ProjectLadon/PowerHardware/README.md

# PowerHardware
Solar panel MPPT/battery charger/power combiner hardware
