ProjectLadon/PowerHardware/Combiner/BatteryChargerCombinerBoM.xlsx

Qty | Q3 | Value | Device | Package | Parts | Description | Part Number | Manufacturer | Notes
3 | 9 |  | DIODESOD-123 | SOD-123 | D7, D8, D9 | Diode | MBR0580S1-7 (https://www.digikey.com/product-detail/en/diodes-incorporated/MBR0580S1-7/MBR0580S1-7DICT-ND/5080371) | Diodes Inc | Digikey
2 | 6 |  | DIODESOT23_REFLOW | SOT23-R | D3, D4 | Diode | BAT750-TP (https://www.digikey.com/product-detail/en/micro-commercial-co/BAT750-TP/BAT750-TPMSCT-ND/7681652) | Micro Commercial | Digikey
4 | 12 |  | R-EU_R0603 | R0603 | R5, R6, R16, R17 | RESISTOR, European symbol |  |  | Digikey
2 | 6 | 100K | R-EU_R0603 | R0603 | R11, R24 | RESISTOR, European symbol | From stock |  | Digikey
14 | 42 | 100R | R-EU_R0603 | R0603 | R12, R19, R30, R33, R34, R40, R43, R44, R53, R54, R65, R68, R69, R71 | RESISTOR, European symbol | RC0603FR-07100RL (https://www.digikey.com/product-detail/en/yageo/RC0603FR-07100RL/311-100HRCT-ND/729835) | Yageo | Digikey
17 | 51 | 100n | C-EUC0603 | C0603 | C3, C4, C16, C17, C21, C24, C26, C28, C29, C30, C31, C32, C33, C34, C35, C38, C39 | CAPACITOR, European symbol | From stock |  | Digikey
15 | 45 | 10K | R-EU_R0603 | R0603 | R7, R8, R20, R21, R56, R57, R60, R73, R75, R77, R78, R85, R86, R87, R88 | RESISTOR, European symbol | From stock |  | Digikey
11 | 33 | 10M | R-EU_R0603 | R0603 | R27, R28, R35, R37, R51, R52, R55, R66, R67, R70, R72 | RESISTOR, European symbol | RC0603FR-0710ML (https://www.digikey.com/product-detail/en/yageo/RC0603FR-0710ML/311-10.0MHRCT-ND/729828) | Yageo | Digikey
2 | 6 | 10R | R-EU_R0603 | R0603 | R29, R36 | RESISTOR, European symbol | RC0603FR-0710RL (https://www.digikey.com/product-detail/en/yageo/RC0603FR-0710RL/311-10.0HRCT-ND/729826) | Yageo | Digikey
2 | 6 | 10R | R-EU_R1206 | R1206 | R2, R18 | RESISTOR, European symbol | RC1206FR-0710RL (https://www.digikey.com/product-detail/en/yageo/RC1206FR-0710RL/311-10.0FRCT-ND/731429) | Yageo | Digikey
6 | 18 | 10u | C-EUC1210 | C1210 | C2, C7, C8, C12, C13, C18 | CAPACITOR, European symbol | CC1210ZKY5VGBB106 (https://www.digikey.com/product-detail/en/yageo/CC1210ZKY5VGBB106/311-3546-1-ND/7164567) |  | Digikey
2 | 6 | 10u | INDUCTOR-DG6050 | DG6050 | L1, L2 |  | 1264EY-100M=P3 (https://www.digikey.com/product-detail/en/murata-electronics-north-america/1264EY-100M=P3/490-10814-1-ND/5271556) | Murata | Digikey
2 | 6 | 12K | R-EU_R0603 | R0603 | R62, R64 | RESISTOR, European symbol | From stock |  | Digikey
5 | 15 | 15K | R-EU_R0603 | R0603 | R4, R15, R59, R74, R76 | RESISTOR, European symbol | RC0603FR-0715KL (https://www.digikey.com/product-detail/en/yageo/RC0603FR-0715KL/311-15.0KHRCT-ND/729900) | Yageo | Digikey
6 | 18 | 1K | R-EU_R0603 | R0603 | R79, R80, R81, R82, R83, R84 | RESISTOR, European symbol | From stock |  | Digikey
6 | 18 | 1u | C-EUC0603 | C0603 | C5, C6, C14, C15, C22, C27 | CAPACITOR, European symbol | From stock |  | Digikey
2 | 6 | 220mA/50V/3.5O | MOSFET-NCH-BSS138 | SOT23-3 | Q6, Q7 | N-channel MOSFETs | NTR5103NT1G (https://www.digikey.com/product-detail/en/on-semiconductor/NTR5103NT1G/NTR5103NT1GOSCT-ND/5801875) | ON Semi | Digikey
2 | 6 | 22p | C-EUC0603 | C0603 | C10, C20 | CAPACITOR, European symbol | 06035A220JAT2A (https://www.digikey.com/product-detail/en/avx-corporation/06035A220JAT2A/478-1167-1-ND/564199) | AVX | Digikey
2 | 6 | 232K | R-EU_R0603 | R0603 | R3, R14 | RESISTOR, European symbol | RC0603FR-07232KL (https://www.digikey.com/product-detail/en/yageo/RC0603FR-07232KL/311-232KHRCT-ND/730019) | Yageo | Digikey
2 | 6 | 2R | R-EU_R0603 | R0603 | R1, R13 | RESISTOR, European symbol | RMCF0603FT2R00 (https://www.digikey.com/product-detail/en/stackpole-electronics-inc/RMCF0603FT2R00/RMCF0603FT2R00CT-ND/6053160) | Stackpole | Digikey
2 | 6 | 2S-BATTERYSMD | 2S-BATTERYSMD | JST-XH3-SMD | BAT1, BAT2 | JST XH connector for a 2S LiPo battery with balancing | S3B-XH-SM4-TB(LF)(SN) (https://www.digikey.com/product-detail/en/jst-sales-america-inc/S3B-XH-SM4-TB-LF-SN/455-2263-1-ND/1651061) | JST | Digikey
2 | 6 | 2m | R-EU_R2512 | R2512 | R32, R42 | RESISTOR, European symbol | PA2512FKF070R002E (https://www.digikey.com/product-detail/en/yageo/PA2512FKF070R002E/YAG2137CT-ND/5139585) | Yageo | Digikey
5 | 15 | 2u2 | C-EUC0603 | C0603 | C1, C11, C23, C25, C37 | CAPACITOR, European symbol | CL10A225KL8NNNC (https://www.digikey.com/product-detail/en/samsung-electro-mechanics/CL10A225KL8NNNC/1276-6726-1-ND/5961585) | Samsung | Digikey
2 | 6 | 300K | R-EU_R0603 | R0603 | R10, R23 | RESISTOR, European symbol | RC0603FR-07300KL (https://www.digikey.com/product-detail/en/yageo/RC0603FR-07300KL/311-300KHRCT-ND/730092) | Yageo | Digikey
4 | 12 | 4.3A/20V/54mO | MOSFET_PCH-IRLML2244 | SOT23-3 | Q8, Q9, Q10, Q11 | P-channel MOSFETs | DMP3099L-7 (https://www.digikey.com/product-detail/en/diodes-incorporated/DMP3099L-7/DMP3099L-7DICT-ND/5218217) | Diodes Inc | Digikey
2 | 6 | 40m | R-EU_R2512 | R2512 | R9, R22 | RESISTOR, European symbol | PE2512FKE070R04L (https://www.digikey.com/product-detail/en/yageo/PE2512FKE070R04L/YAG2155CT-ND/5139603) | Yageo | Digikey
1 | 3 | 470p | C-EUC0603 | C0603 | C36 | CAPACITOR, European symbol | CL10B471KB8NNNC (https://www.digikey.com/product-detail/en/samsung-electro-mechanics/CL10B471KB8NNNC/1276-1094-1-ND/3889180) | Samsung | Digikey
7 | 21 | 4K7 | R-EU_R0603 | R0603 | R45, R46, R47, R48, R49, R50, R58 | RESISTOR, European symbol | From stock |  | Digikey
2 | 6 | 4u7 | C-EUC1210 | C1210 | C9, C19 | CAPACITOR, European symbol | CC1210KKX5R9BB475 (https://www.digikey.com/product-detail/en/yageo/CC1210KKX5R9BB475/311-3533-1-ND/7164554) |  | Digikey
4 | 12 | 5K1 | R-EU_R0603 | R0603 | R25, R26, R38, R39 | RESISTOR, European symbol | RC0603FR-075K1L (https://www.digikey.com/product-detail/en/yageo/RC0603FR-075K1L/311-5.10KHRCT-ND/730215) | Yageo | Digikey
2 | 6 | 5R | R-EU_R0603 | R0603 | R31, R41 | RESISTOR, European symbol | RMCF0603FT4R99 (https://www.digikey.com/product-detail/en/stackpole-electronics-inc/RMCF0603FT4R99/RMCF0603FT4R99CT-ND/2418080) | Stackpole | Digikey
1 | 3 | 74AHC1G07DBV | 74AHC1G07DBV | SOT23-5 | U8 | Single Buffer/Driver With Open-Drain Output | MC74VHC1G07DTT1G (https://www.digikey.com/product-detail/en/on-semiconductor/MC74VHC1G07DTT1G/MC74VHC1G07DTT1GOSCT-ND/1967117) | ON Semi | Digikey
4 | 12 | 74AUC1G06DBV | 74AUC1G06DBV | SOT23-5 | U9, U14, U15, U16 | Single Inverter Buffer/Driver With Open-Drain Output | SN74LVC1G06DBVR (https://www.digikey.com/product-detail/en/texas-instruments/SN74LVC1G06DBVR/296-8483-1-ND/377451) | TI | Digikey
2 | 6 | 75K | R-EU_R0603 | R0603 | R61, R63 | RESISTOR, European symbol | RC0603FR-0775KL (https://www.digikey.com/product-detail/en/yageo/RC0603FR-0775KL/311-75.0KHRCT-ND/730325) | Yageo | Digikey
5 | 15 | BLU | LEDCHIP-LED0603 | CHIP-LED0603 | 5V_PWR, BAT1_PWR, BAT2_PWR, PANEL1_PWR, PANEL2_PWR | LED | 150060BS75000 (https://www.digikey.com/product-detail/en/wurth-electronics-inc/150060BS75000/732-4966-1-ND/4489893) | Wurth | Digikey
2 | 6 | BQ24650 | BQ24650 | QFN16 | U1, U4 | TI LiPo charger with MPPT | BQ24650RVAT (https://www.digikey.com/product-detail/en/texas-instruments/BQ24650RVAT/296-27699-1-ND/2352706) | TI | Digikey
2 | 6 | BQ28Z610 | BQ28Z610 | PDSO-N12 | U2, U3 | 2S LiPo balancer/fuel gauge | BQ28Z610DRZT (https://www.digikey.com/product-detail/en/texas-instruments/BQ28Z610DRZT/296-43394-1-ND/5813465) | TI | Digikey
4 | 12 | DMN6040SSD-13 | IRF8313P | SO-08 | Q1, Q2, Q3, Q4 | HEXFET(R) Power MOSFET | DMN6040SSD-13 (https://www.digikey.com/product-detail/en/diodes-incorporated/DMN6040SSD-13/DMN6040SSD-13DICT-ND/3481122) | Diodes Inc | Digikey
1 | 3 | DMP4047SSD-13 | DMP4047SSD-13 | SO08 | Q5 | Dual P MOSFET | DMP4047SSD-13 (https://www.digikey.com/product-detail/en/diodes-incorporated/DMP4047SSD-13/DMP4047SSD-13DICT-ND/5147416) | Diodes Inc | Digikey
1 | 3 | GRN | LEDCHIP-LED0603 | CHIP-LED0603 | 3V3_PWR | LED | 150060GS75000 (https://www.digikey.com/product-detail/en/wurth-electronics-inc/150060GS75000/732-4971-1-ND/4489896) | Wurth | Digikey
1 | 3 | HEADER_POS15_70545 | HEADER_POS15_70545 | 70545-POS15 | SYSTEM | Molex -C-Gridï¿½ / SL Series connector | 705450049 (https://www.digikey.com/product-detail/en/molex-connector-corporation/0705450049/WM14780-ND/3302397) | Molex | Digikey
3 | 9 | HEADER_POS3_70545 | HEADER_POS3_70545 | 70545-POS3 | BAT1_TS, BAT2_TS, TAIL | Molex -C-Gridï¿½ / SL Series connector | 705450072 (https://www.digikey.com/product-detail/en/molex-llc/0705450072/WM14782-ND/3302409) | Molex | Digikey
3 | 9 | HEADER_POS4_70545 | HEADER_POS4_70545 | 70545-POS4 | ANEMOMETER, MASTHEAD, ROTATION | Molex -C-Gridï¿½ / SL Series connector | 705450003 (https://www.digikey.com/product-detail/en/molex-connector-corporation/0705450003/WM4186-ND/455677) | Molex | Digikey
1 | 3 | LMV358 | LMV358SOIC | SO08 | U17 | IC LMV358 DUAL OP AMP | LMV358SG-13 (https://www.digikey.com/product-detail/en/diodes-incorporated/LMV358SG-13/LMV358SG-13DICT-ND/2182572) | Diodes Inc | Digikey
1 | 3 | MIC5219 3.3V | V_REG_MIC52193.3V | SOT23-5 | U11 | V_REG MIC5219 | MIC5219-3.3YM5-TR (https://www.digikey.com/product-detail/en/microchip-technology/MIC5219-3.3YM5-TR/576-1281-1-ND/771902) | Microchip | Digikey
1 | 3 | female Mill-Max 0.1" header strip | MKR1000-SMD | MKR1000-SMD | U12 | 0.1" SMD header -- cut to length. Mates with Mill-Max series 350 or 800 | ED4164-63-ND (https://www.digikey.com/product-detail/en/mill-max-manufacturing-corp/310-43-163-41-105000/ED4164-63-ND/4455145) | Mill-Max | Digikey
1 | 3 | PWR | PWR | JST-XH2-THRUHOLE | PWR_OUT |  | S2B-XH-A(LF)(SN) (https://www.digikey.com/product-detail/en/jst-sales-america-inc/S2B-XH-A-LF-SN/455-2257-ND/1651055) | JST | Digikey
4 | 12 | RED | LEDCHIP-LED0603 | CHIP-LED0603 | BAT1_STAT1, BAT1_STAT2, BAT2_STAT1, BAT2_STAT2 | LED | 150060RS75000 (https://www.digikey.com/product-detail/en/wurth-electronics-inc/150060RS75000/732-4978-1-ND/4489899) | Wurth | Digikey
2 | 6 | SCHOTTKY-SOD128 | SCHOTTKY-SOD128 | SOD-128 | D1, D2 |  | PMEG4020ETP,115 (https://www.digikey.com/product-detail/en/nexperia-usa-inc/PMEG4020ETP115/1727-1730-1-ND/4581267) | Nexperia | Digikey
1 | 3 | STWD100 | STWD100 | DBV-R-PDSO-G5 | U13 |  | STWD100NYWY3F (https://www.digikey.com/product-detail/en/stmicroelectronics/STWD100NYWY3F/497-10058-1-ND/2175107) | STM | Digikey
1 | 3 | TCA9543A | TCA9543A | SO-14 | U5 | 2 port I2C mux | TCA9543ADR (https://www.digikey.com/product-detail/en/texas-instruments/TCA9543ADR/296-42064-1-ND/5246241) | TI | Digikey
1 | 3 | TS7211 | TS7211 | DBV-R-PDSO-G5 | U10 | Single rail to rail differential comparator. | TS7211AILT (https://www.digikey.com/product-detail/en/stmicroelectronics/TS7211AILT/497-3046-1-ND/634884) | STM | Digikey
1 | 3 | WE-78 | 5V | WE-78 | U6 |  | 173950578 (https://www.digikey.com/product-detail/en/wurth-electronics-inc/173950578/732-8243-5-ND/5725367) | Wurth | Digikey
1 | 3 | WE-78 | 3.3V | WE-78 | U7 |  | 173950378 (https://www.digikey.com/product-detail/en/wurth-electronics-inc/173950378/732-8242-5-ND/5725366) | Wurth | Digikey
