ProjectLadon/PowerHardware/MastheadLight/MastheadLightBoM.xlsx

Qty | Value | Device | Package | Parts | Description | Part Number | Manufacturer | Supplier
1 |  | DIODESOD-123 | SOD-123 | D1 | Diode | MBR0580S1-7 (https://www.digikey.com/product-detail/en/diodes-incorporated/MBR0580S1-7/MBR0580S1-7DICT-ND/5080371) | Diodes Inc | Digikey
6 |  | PINHD-2X3 | 2X03 | JP1, JP2, JP3, JP4, JP5, JP6 | PIN HEADER | PPTC032LFBN-RC (https://www.digikey.com/product-detail/en/sullins-connector-solutions/PPTC032LFBN-RC/S7071-ND/810210) |  | Digikey
1 | 1R1 | R-EU_R1206 | R1206 | R1 | RESISTOR, European symbol | ERJ-8BQF1R1V (https://www.digikey.com/product-detail/en/panasonic-electronic-components/ERJ-8BQF1R1V/P17601TR-ND/5647634) | Panasonic | Digikey
1 | 1u | C-EUC0603 | C0603 | C2 | CAPACITOR, European symbol | From stock |  | Digikey
1 | 33 uH/390 mA | INDUCTOR-LQH32N | C1210 | L1 |  | CBC3225T330MR (https://www.digikey.com/product-detail/en/taiyo-yuden/CBC3225T330MR/587-5508-1-ND/7067184) | Taiyo Yuden | Digikey
3 | 47K | R-EU_R0603 | R0603 | R2, R3, R4 | RESISTOR, European symbol | From stock |  | Digikey
1 | 4u7 | C-EUC1206 | C1206 | C1 | CAPACITOR, European symbol | TMK316BJ475KL-T (https://www.digikey.com/product-detail/en/taiyo-yuden/TMK316BJ475KL-T/587-1336-1-ND/931113) | Taiyo Yuden | Digikey
1 | HEADER_POS4_70543 | HEADER_POS4_70543 | 70543-POS4 | X1 | Molex -C-Gridï¿½ / SL Series connector | 705450003 (https://www.digikey.com/product-detail/en/molex-connector-corporation/0705450003/WM4186-ND/455677) | Molex | Digikey
1 | LM3407 | LM3407 | MSOP8-GND | U1 |  | LM3407MY/NOPB (https://www.digikey.com/product-detail/en/texas-instruments/LM3407MY-NOPB/LM3407MY-NOPBCT-ND/1993974) | TI | Digikey
1 | WE-78 | 5V | WE-78 | U6 |  | 173950578 (https://www.digikey.com/product-detail/en/wurth-electronics-inc/173950578/732-8243-5-ND/5725367) | Wurth | Digikey
6 |  | PINHD-2X3_2.54-SMD-90ï¿½ | 2X03SMD/90 | JP1 | PIN HEADER | TSM-103-01-L-DH (https://www.digikey.com/product-detail/en/samtec-inc/TSM-103-01-L-DH/SAM9026-ND/2501234) |  | Digikey
12 | 100n | C-EUC0603 | C0603 | C1, C2 | CAPACITOR, European symbol | From stock |  | Digikey
6 | LED | LED | LM561C | D1 |  | SPMWHT541ML5XAR0S6 (https://www.digikey.com/product-detail/en/samsung-semiconductor-inc/SPMWHT541ML5XAR0S6/1510-2182-1-ND/6569493) | Samsung | Digikey
12 | WS2812B5050 | WS2812B5050 | WS2812B | LED1, LED2 |  | NeoPixel 5050 RGB LED (https://www.adafruit.com/product/1655) |  | Adafruit
