ProjectLadon/PowerHardware/MPPTBatteryCharger/MPPTBatteryCharger.brd

## EAGLE design MPPTBatteryCharger/MPPTBatteryCharger.brd (2019-10-13)

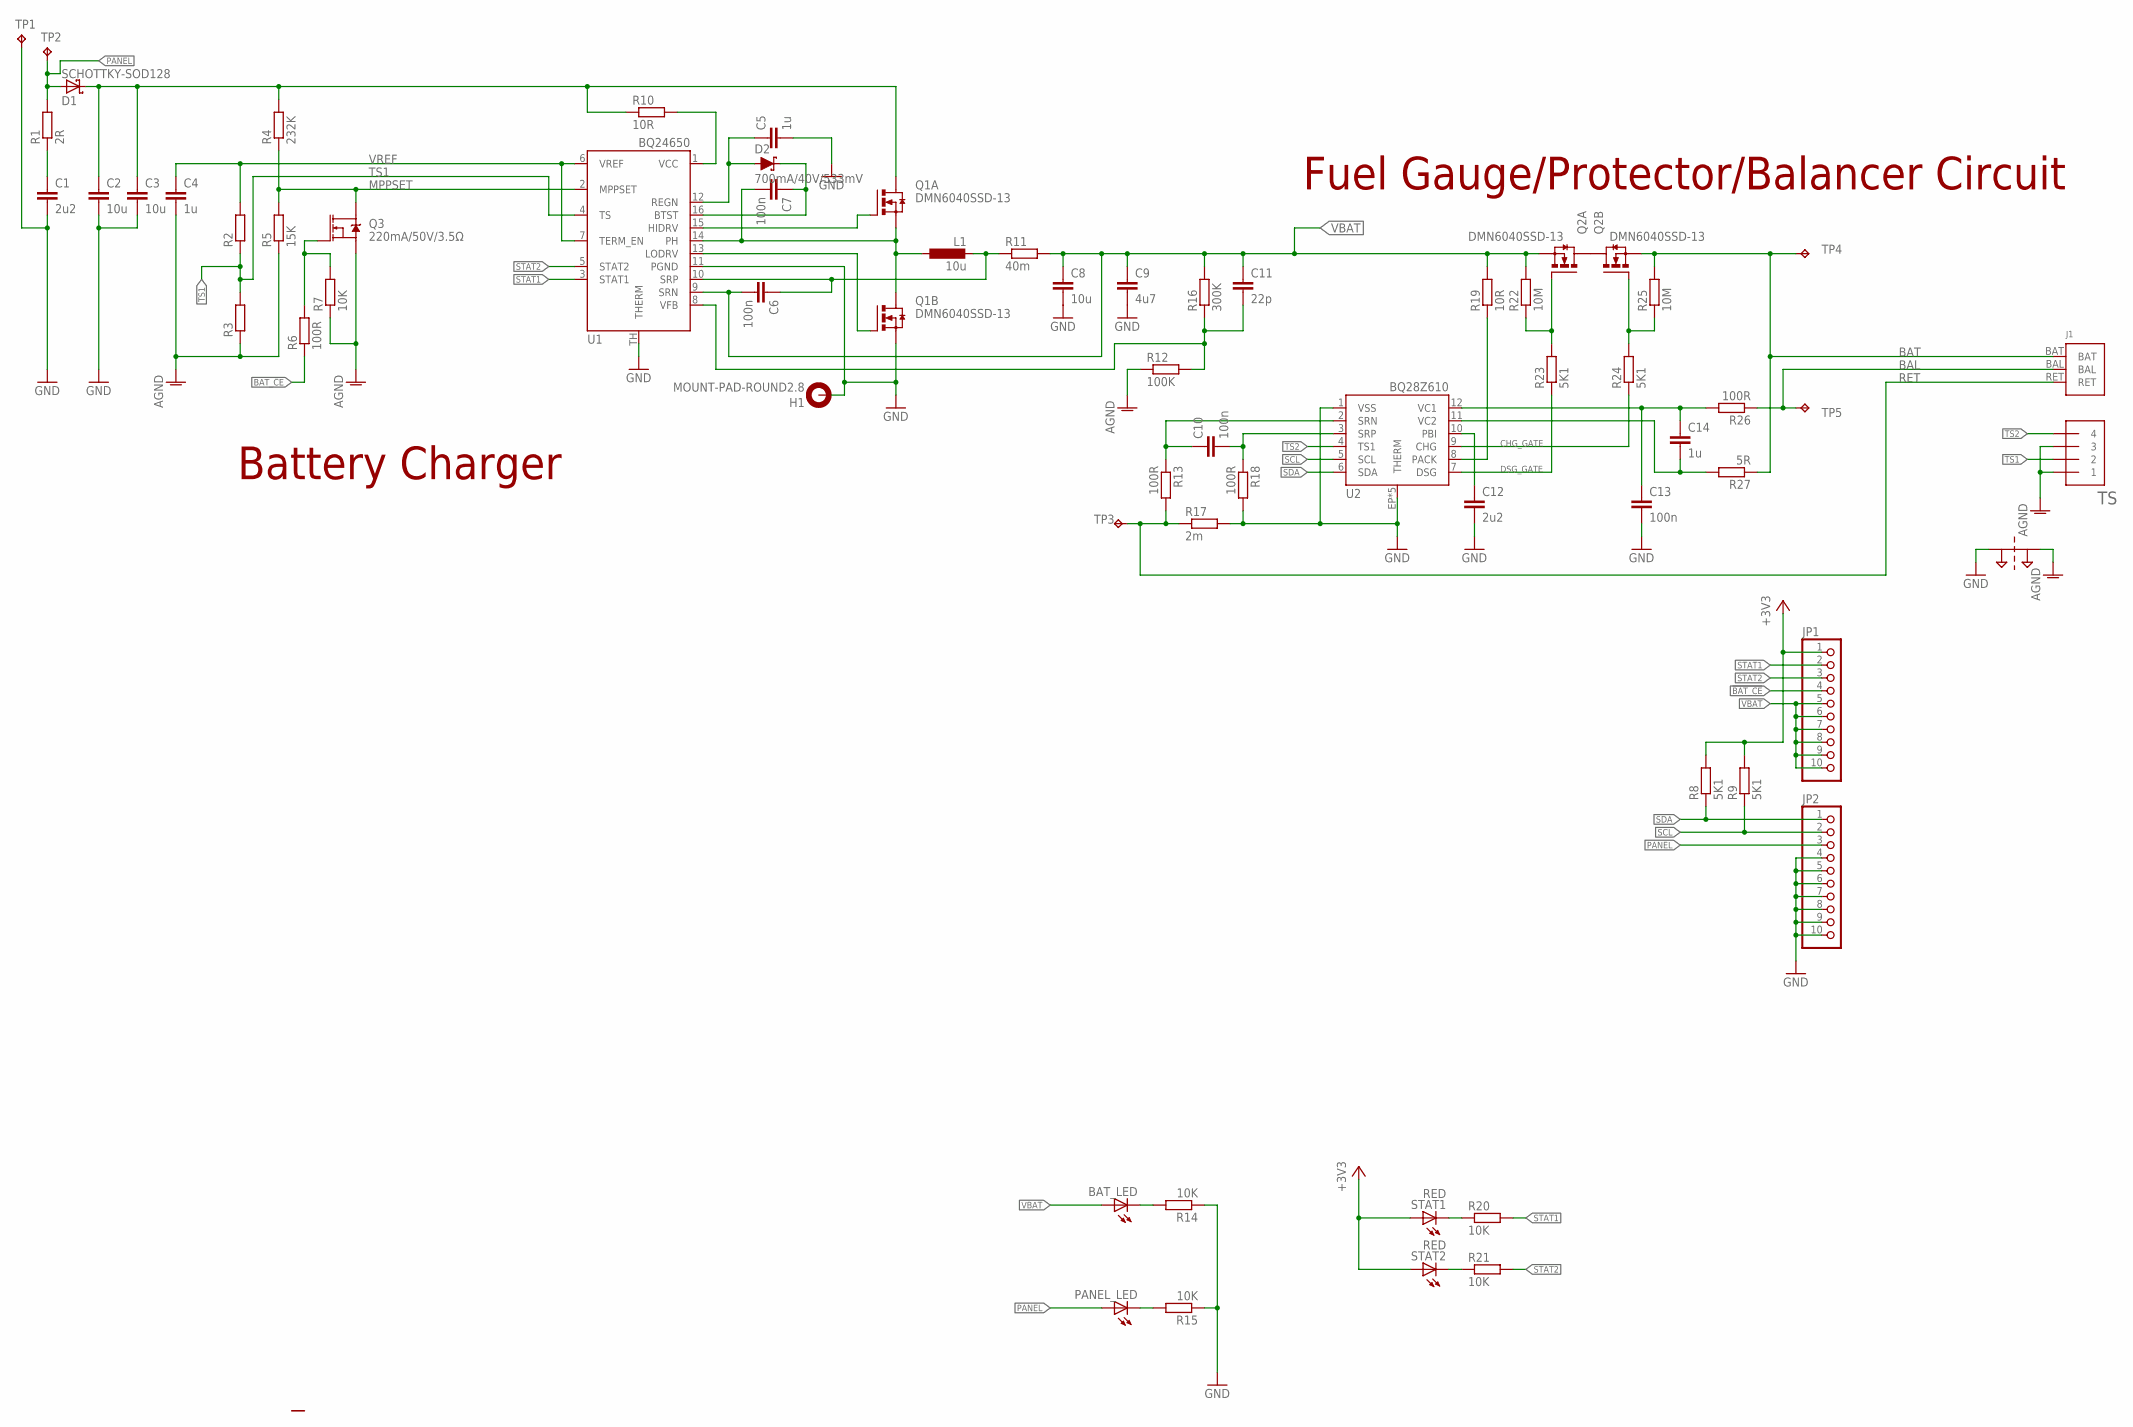
[picture p1: schematic MPPTBatteryCharger.sch]

Parts:
BAT_LED: LEDCHIP-LED0603; CHIP-LED0603
C1, C12: 2u2; C0603
C2, C3, C8: 10u; C1210
C4, C5, C14: 1u; C0603
C6, C7, C10, C13: 100n; C0603
C9: 4u7; C1210
C11: 22p; C0603
D1: SCHOTTKY-SOD128; SOD-128
D2: 700mA/40V/533mV; SOT23-3
H1: MOUNT-PAD-ROUND2.8; 2,8-PAD
J1: 2S-BATTERYSMD; JST-XH3-SMD
JP1, JP2: PINHD-1X10; 1X10
L1: 10u; DG6050
PANEL_LED: LEDCHIP-LED0603; CHIP-LED0603
Q1, Q2: DMN6040SSD-13; SO-08
Q3: 220mA/50V/3.5Ω; SOT23-3
R1: 2R; R0603
R2, R3: R-EU_R0603; R0603
R4: 232K; R0603
R5: 15K; R0603
R6, R13, R18, R26: 100R; R0603
R7, R14, R15, R20, R21: 10K; R0603
R8, R9, R23, R24: 5K1; R0603
R10: 10R; R1206
R11: 40m; R2512
R12: 100K; R0603
R16: 300K; R0603
R17: 2m; R2512
R19: 10R; R0603
R22, R25: 10M; R0603
R27: 5R; R0603
STAT1, STAT2: RED; CHIP-LED0603
SUPPLY1: 2PT_GND_TIE
TP1, TP2, TP3, TP4, TP5: TPPAD1-13Y; P1-13Y
TS: STRAWSON_EAGLE_LIB_JST_SH_4; STRAWSON_EAGLE_LIB_JST_SH_4_SMD
U1: BQ24650; QFN16
U2: BQ28Z610; PDSO-N12

Connections:
!BAT_CE!: JP1.4, R6.1
+3V3: JP1.1, R8.2, R9.2, STAT1.A, STAT2.A
AGND: C4.2, Q3.2 (S), R3.1, R5.1, R7.1, R12.1, SUPPLY1.P$2, TS.1, TS.3
BAL: J1.BAL, R26.1, TP5.TP
BAT: J1.BAT, Q2.1 (S), R25.2, R27.1, TP4.TP
CHG_GATE: R24.1, U2.9 (CHG)
DSG_GATE: R23.1, U2.7 (DSG)
GND: C1.2, C2.2, C3.2, C5.2, C8.2, C9.2, C12.2, C13.2, H1.B2,8, JP2.4, JP2.5, JP2.6, JP2.7, JP2.8, JP2.9, JP2.10, Q1.1 (S), R14.1, R15.1, R17.2, R18.2, SUPPLY1.P$1, TP1.TP, U1.11 (PGND), U1.TH (THERM), U2.1 (VSS), U2.EP (THERM), U2.EP1 (THERM), U2.EP2 (THERM), U2.EP3 (THERM), U2.EP4 (THERM)
MPPSET: Q3.3 (D), R4.1, R5.2, U1.2 (MPPSET)
unnamed: C1.1, R1.1
unnamed: R10.2, U1.1 (VCC)
unnamed: C2.1, C3.1, D1.C, Q1.5 (D), Q1.6 (D), R4.2, R10.1
unnamed: Q1.4 (G), U1.15 (HIDRV)
unnamed: C7.2, L1.1, Q1.3 (S), Q1.7 (D), Q1.8 (D), U1.14 (PH)
unnamed: Q1.2 (G), U1.13 (LODRV)
unnamed: Q3.1 (G), R6.2, R7.2
unnamed: C6.1, L1.2, R11.1, U1.10 (SRP)
unnamed: C7.1, D2.3 (C), U1.16 (BTST)
unnamed: C5.1, D2.1 (A), U1.12 (REGN)
unnamed: C11.2, R12.2, R16.1, U1.8 (VFB)
unnamed: R20.1, STAT1.C
unnamed: R19.1, U2.8 (PACK)
unnamed: Q2.5 (D), Q2.6 (D), Q2.7 (D), Q2.8 (D)
unnamed: Q2.4 (G), R22.1, R23.2
unnamed: Q2.2 (G), R24.2, R25.1
unnamed: C13.1, C14.1, R26.2, U2.12 (VC1)
unnamed: C14.2, R27.2, U2.11 (VC2)
unnamed: C12.1, U2.10 (PBI)
unnamed: C10.1, R13.1, U2.2 (SRN)
unnamed: C10.2, R18.1, U2.3 (SRP)
unnamed: R21.1, STAT2.C
unnamed: BAT_LED.C, R14.2
unnamed: PANEL_LED.C, R15.2
PANEL: D1.A, JP2.3, PANEL_LED.A, R1.2, TP2.TP
RET: J1.RET, R13.2, R17.1, TP3.TP
SCL: JP2.2, R9.1, U2.5 (SCL)
SDA: JP2.1, R8.1, U2.6 (SDA)
STAT1: JP1.2, R20.2, U1.3 (STAT1)
STAT2: JP1.3, R21.2, U1.5 (STAT2)
TS1: R2.1, R3.2, TS.2, U1.4 (TS)
TS2: TS.4, U2.4 (TS1)
VBAT: BAT_LED.A, C6.2, C8.1, C9.1, C11.1, JP1.5, JP1.6, JP1.7, JP1.8, JP1.9, JP1.10, Q2.3 (S), R11.2, R16.2, R19.2, R22.2, U1.9 (SRN)
VREF: C4.1, R2.2, U1.6 (VREF), U1.7 (TERM_EN)

Notes on the sheet:
Battery Charger
Fuel Gauge/Protector/Balancer Circuit

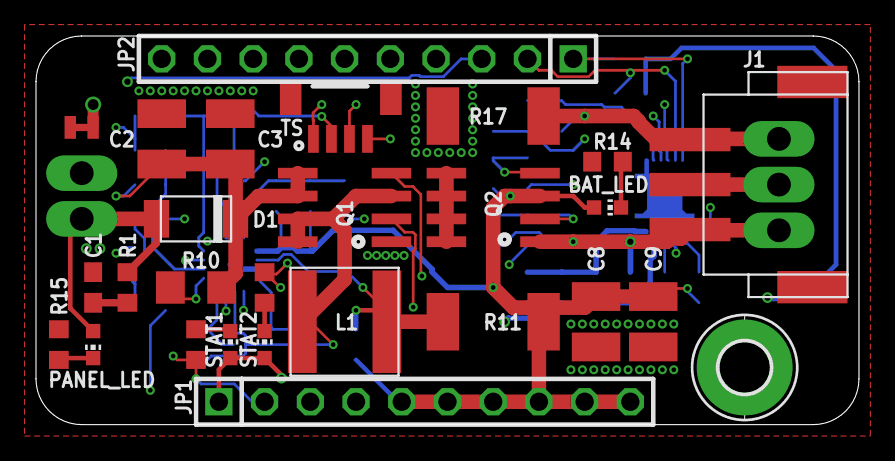
[picture p2: board MPPTBatteryCharger.brd from above]

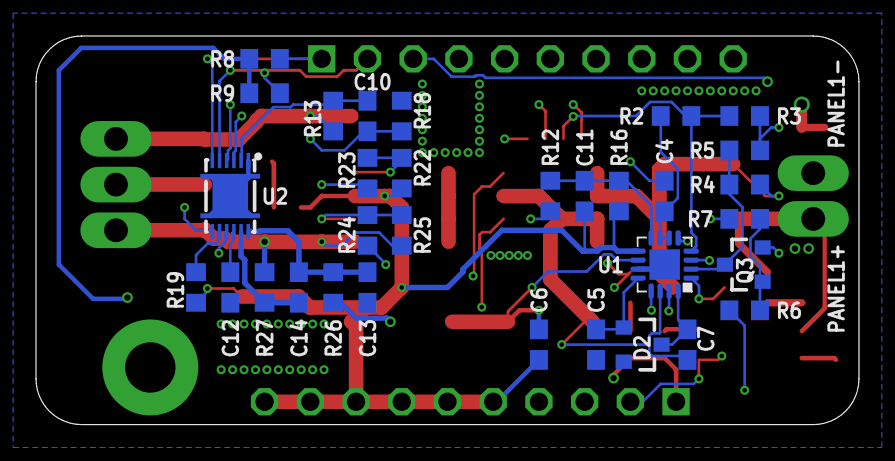
[picture p3: board MPPTBatteryCharger.brd from below]

Board: 4 copper layers, 45.7 x 21.6 mm, 64 parts (35 on the bottom side), 43 nets.
