ProjectLadon/PowerHardware/ModularCombinerBoard/BatteryCombinerControlBoard.brd

## EAGLE design ModularCombinerBoard/BatteryCombinerControlBoard.brd (2019-10-13)

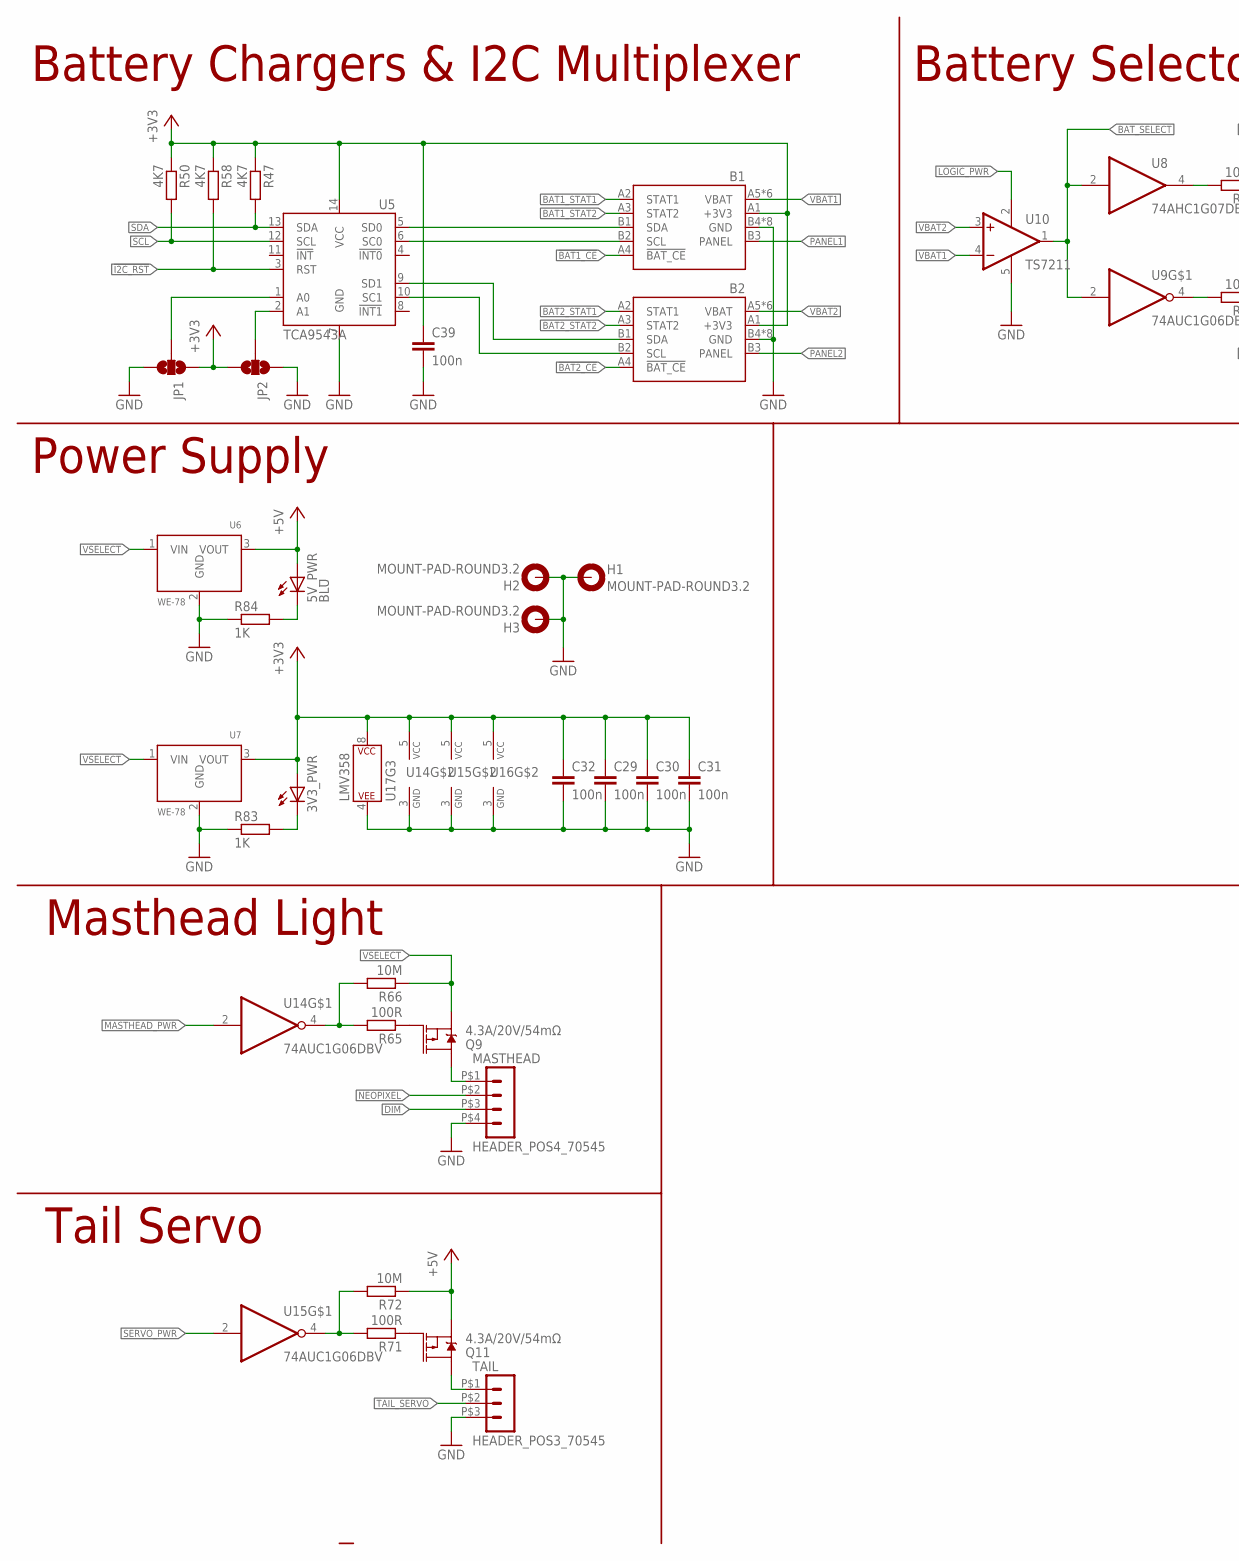
[picture p4: schematic BatteryCombinerControlBoard.sch, sheet 1, part in row 1, column 1]

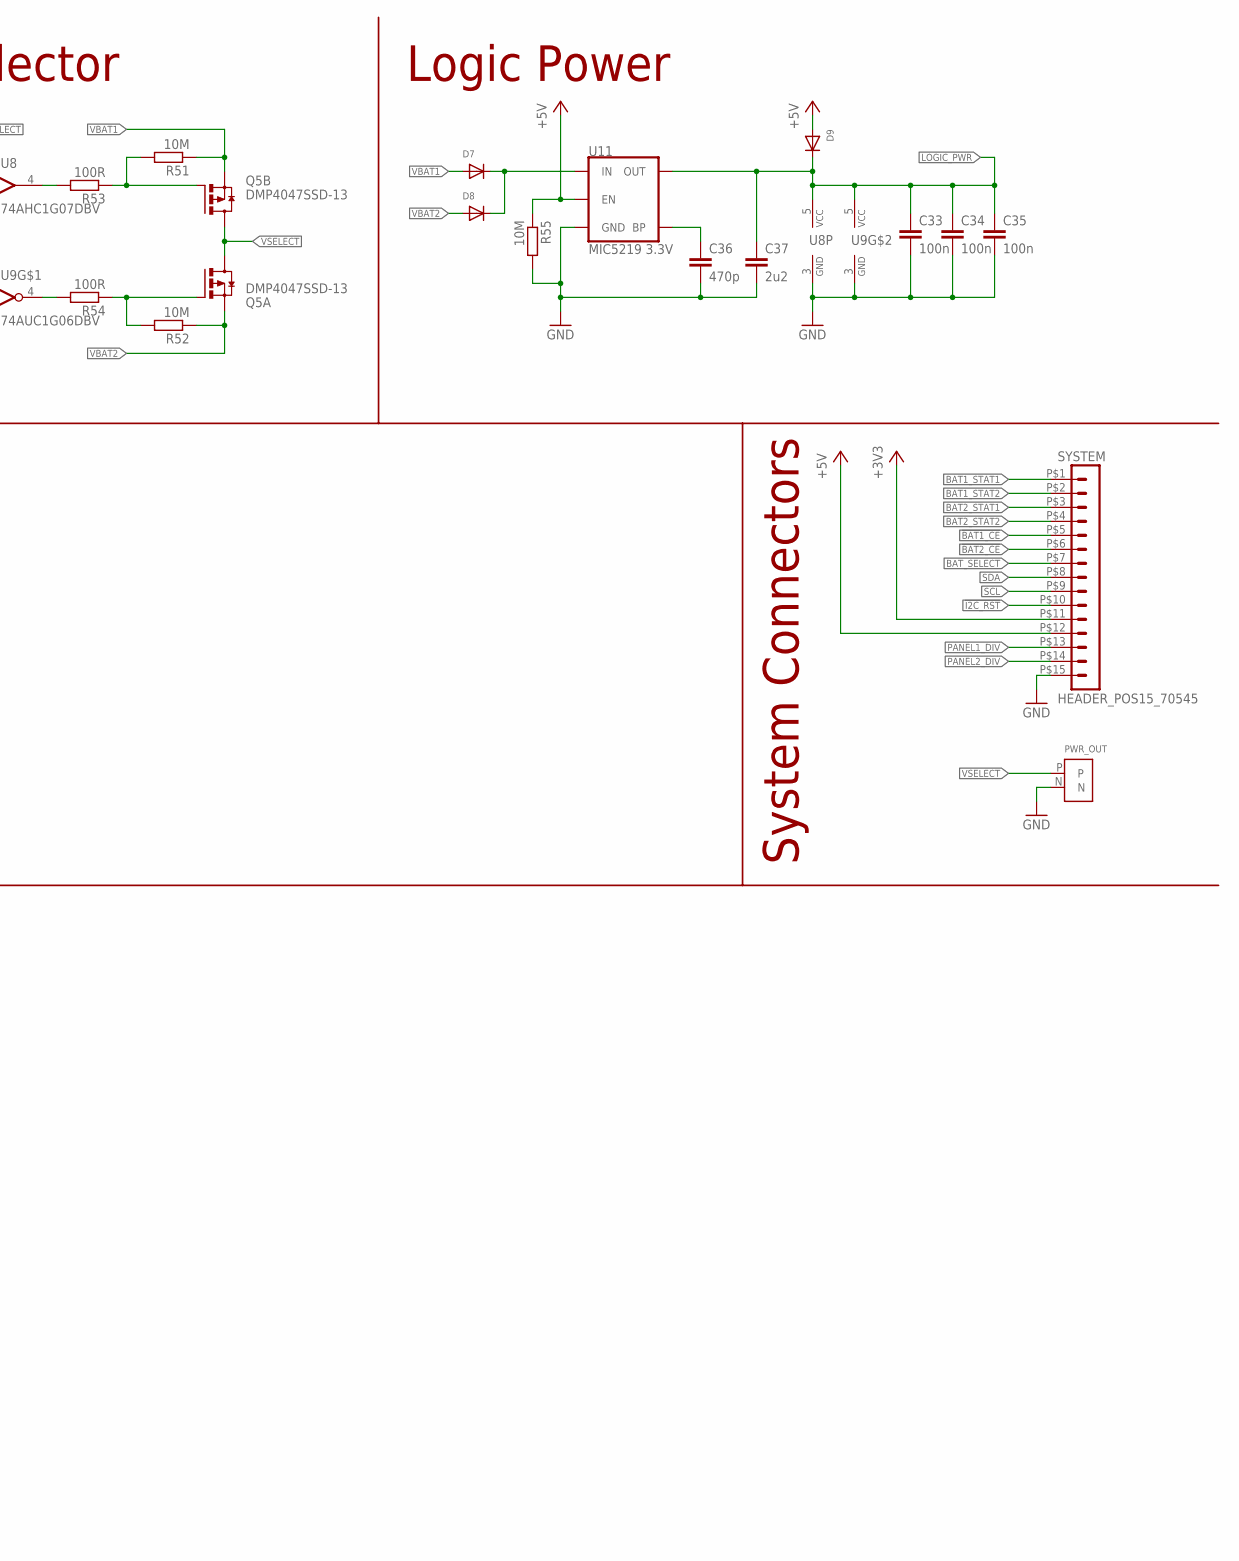
[picture p5: schematic BatteryCombinerControlBoard.sch, sheet 1, part in row 1, column 2]

Parts:
3V3_PWR: GRN; CHIP-LED0603
5V_PWR: BLU; CHIP-LED0603
B1, B2: MPPTCHARGER
C29, C30, C31, C32, C33, C34, C35, C39: 100n; C0603
C36: 470p; C0603
C37: 2u2; C0603
D7, D8, D9: DIODESOD-123; SOD-123
H1, H2, H3: MOUNT-PAD-ROUND3.2; 3,2-PAD
JP1, JP2: JUMPER-SMT_3_NO_SILK; SMT-JUMPER_3_NO_SILK
MASTHEAD: HEADER_POS4_70545; 70545-POS4
PWR_OUT: PWR; JST-XH2-THRUHOLE
Q5: DMP4047SSD-13; SO08
Q9, Q11: 4.3A/20V/54mΩ; SOT23-3
R47, R50, R58: 4K7; R0603
R51, R52, R55, R66, R72: 10M; R0603
R53, R54, R65, R71: 100R; R0603
R83, R84: 1K; R0603
SYSTEM: HEADER_POS15_70545; 70545-POS15
TAIL: HEADER_POS3_70545; 70545-POS3
U5: TCA9543A; SO-14
U6, U7: WE-78
U8: 74AHC1G07DBV; SOT23-5
U9, U14, U15, U16: 74AUC1G06DBV; SOT23-5
U10: TS7211; DBV-R-PDSO-G5
U11: MIC5219 3.3V; SOT23-5
U17: LMV358; SO08

Connections:
!BAT1_CE!: B1.A4 (!BAT_CE!), SYSTEM.P$5 (5); also elsewhere on the board
!BAT2_CE!: B2.A4 (!BAT_CE!), SYSTEM.P$6 (6); also elsewhere on the board
!I2C_RST!: R58.2, SYSTEM.P$10 (10), U5.3 (RST); also elsewhere on the board
+3V3: 3V3_PWR.A, B1.A1 (+3V3), B2.A1 (+3V3), C29.1, C30.1, C31.1, C32.1, C39.1, JP1.1, JP2.3, R47.1, R50.1, R58.1, SYSTEM.P$11 (11), U5.14 (VCC), U7.3 (VOUT), U14.5 (VCC), U15.5 (VCC), U16.5 (VCC), U17.8 (P$V+); also elsewhere on the board
+5V: 5V_PWR.A, D9.A, Q11.2 (S), R55.1, R72.1, SYSTEM.P$12 (12), U6.3 (VOUT), U11.3 (EN); also elsewhere on the board
BAT1_STAT1: B1.A2 (STAT1), SYSTEM.P$1 (1); also elsewhere on the board
BAT1_STAT2: B1.A3 (STAT2), SYSTEM.P$2 (2); also elsewhere on the board
BAT2_STAT1: B2.A2 (STAT1), SYSTEM.P$3 (3); also elsewhere on the board
BAT2_STAT2: B2.A3 (STAT2), SYSTEM.P$4 (4); also elsewhere on the board
BAT_SELECT: SYSTEM.P$7 (7), U8.2 (I), U9.2 (I), U10.1 (OUT); also elsewhere on the board
DIM: MASTHEAD.P$3 (3); also elsewhere on the board
GND: B1.B4 (GND), B1.B5 (GND), B1.B6 (GND), B1.B7 (GND), B1.B8 (GND), B1.B9 (GND), B1.B10 (GND), B1.H (GND), B2.B4 (GND), B2.B5 (GND), B2.B6 (GND), B2.B7 (GND), B2.B8 (GND), B2.B9 (GND), B2.B10 (GND), B2.H (GND), C29.2, C30.2, C31.2, C32.2, C33.2, C34.2, C35.2, C36.2, C37.2, C39.2, H1.B3,2, H2.B3,2, H3.B3,2, JP1.3, JP2.1, MASTHEAD.P$4 (4), PWR_OUT.N, R55.2, R83.1, R84.1, SYSTEM.P$15 (15), TAIL.P$3 (3), U5.7 (GND), U6.2 (GND), U7.2 (GND), U8.3 (GND), U9.3 (GND), U10.5 (GND), U11.2 (GND), U14.3 (GND), U15.3 (GND), U16.3 (GND), U17.4 (P$V-); also elsewhere on the board
LOGIC_PWR: C33.1, C34.1, C35.1, C37.1, D9.C, U8.5 (VCC), U9.5 (VCC), U10.2 (V+), U11.5 (OUT)
MASTHEAD_PWR: U14.2 (I); also elsewhere on the board
unnamed: Q5.4 (G), R51.2, R53.1
unnamed: JP1.2, U5.1 (A0)
unnamed: JP2.2, U5.2 (A1)
unnamed: Q5.2 (G), R52.2, R54.1
unnamed: R54.2, U9.4 (O)
unnamed: R53.2, U8.4 (O)
unnamed: D7.C, D8.C, U11.1 (IN)
unnamed: MASTHEAD.P$1 (1), Q9.3 (D)
unnamed: C36.1, U11.4 (BP)
unnamed: Q9.1 (G), R65.1
unnamed: R65.2, R66.2, U14.4 (O)
unnamed: Q11.3 (D), TAIL.P$1 (1)
unnamed: Q11.1 (G), R71.1
unnamed: R71.2, R72.2, U15.4 (O)
unnamed: 3V3_PWR.C, R83.2
unnamed: 5V_PWR.C, R84.2
NEOPIXEL: MASTHEAD.P$2 (2); also elsewhere on the board
PANEL1: B1.B3 (PANEL); also elsewhere on the board
PANEL1_DIV: SYSTEM.P$13 (13); also elsewhere on the board
PANEL2: B2.B3 (PANEL); also elsewhere on the board
PANEL2_DIV: SYSTEM.P$14 (14); also elsewhere on the board
SCL: R50.2, SYSTEM.P$9 (9), U5.12 (SCL); also elsewhere on the board
SCL1: B1.B2 (SCL), U5.6 (SC0)
SCL2: B2.B2 (SCL), U5.10 (SC1)
SDA: R47.2, SYSTEM.P$8 (8), U5.13 (SDA); also elsewhere on the board
SDA1: B1.B1 (SDA), U5.5 (SD0)
SDA2: B2.B1 (SDA), U5.9 (SD1)
SERVO_PWR: U15.2 (I); also elsewhere on the board
TAIL_SERVO: TAIL.P$2 (2); also elsewhere on the board
VBAT1: B1.A5 (VBAT), B1.A6 (VBAT), B1.A7 (VBAT), B1.A8 (VBAT), B1.A9 (VBAT), B1.A10 (VBAT), D7.A, Q5.3 (S), R51.1, U10.4 (-IN)
VBAT2: B2.A5 (VBAT), B2.A6 (VBAT), B2.A7 (VBAT), B2.A8 (VBAT), B2.A9 (VBAT), B2.A10 (VBAT), D8.A, Q5.1 (S), R52.1, U10.3 (+IN)
VSELECT: PWR_OUT.P, Q5.5 (D), Q5.6 (D), Q5.7 (D), Q5.8 (D), Q9.2 (S), R66.1, U6.1 (VIN), U7.1 (VIN); also elsewhere on the board

Notes on the sheet:
Battery Chargers & I2C Multiplexer
Battery Selector
System Connectors
Logic Power
Power Supply
Masthead Light
Tail Servo

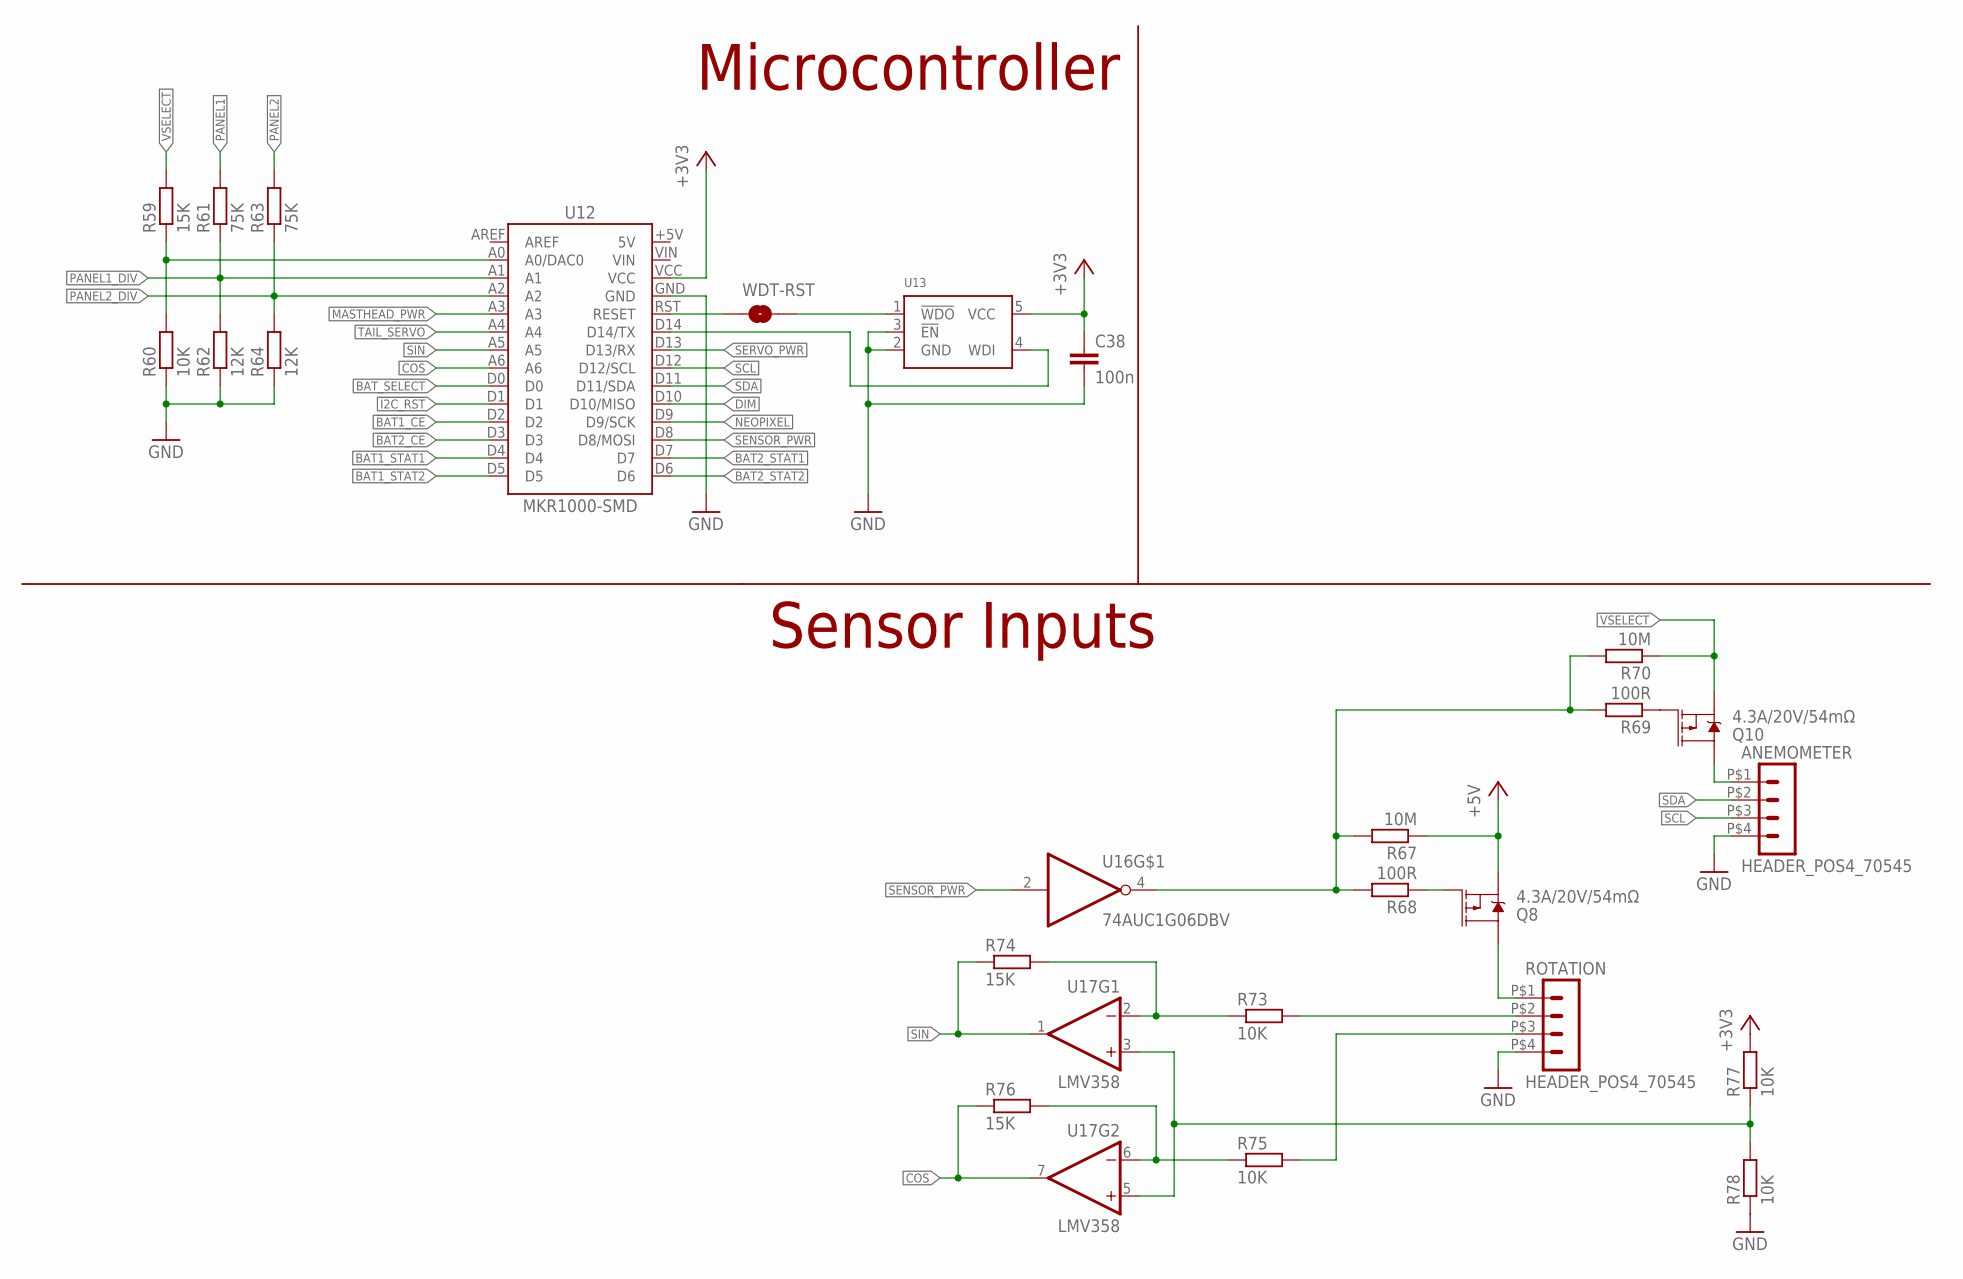
[picture p6: schematic BatteryCombinerControlBoard.sch, sheet 2]

Parts:
ANEMOMETER: HEADER_POS4_70545; 70545-POS4
C38: 100n; C0603
Q8, Q10: 4.3A/20V/54mΩ; SOT23-3
R59, R74, R76: 15K; R0603
R60, R73, R75, R77, R78: 10K; R0603
R61, R63: 75K; R0603
R62, R64: 12K; R0603
R67, R70: 10M; R0603
R68, R69: 100R; R0603
ROTATION: HEADER_POS4_70545; 70545-POS4
U12: MKR1000-SMD
U13: STWD100; DBV-R-PDSO-G5
U16: 74AUC1G06DBV; SOT23-5
U17: LMV358; SO08
WDT-RST: JUMPER-SMT_2_NO_SILK; SMT-JUMPER_2_NO_SILK

Connections:
!BAT1_CE!: U12.D2; also elsewhere on the board
!BAT2_CE!: U12.D3; also elsewhere on the board
!I2C_RST!: U12.D1; also elsewhere on the board
+3V3: C38.1, R77.2, U12.VCC, U13.5 (VCC); also elsewhere on the board
+5V: Q8.2 (S), R67.1; also elsewhere on the board
BAT1_STAT1: U12.D4; also elsewhere on the board
BAT1_STAT2: U12.D5; also elsewhere on the board
BAT2_STAT1: U12.D7; also elsewhere on the board
BAT2_STAT2: U12.D6; also elsewhere on the board
BAT_SELECT: U12.D0; also elsewhere on the board
COS: R76.1, U12.A6, U17.7 (OUT)
COS_IN: R75.2, ROTATION.P$3 (3)
DIM: U12.D10 (D10/MISO); also elsewhere on the board
GND: ANEMOMETER.P$4 (4), C38.2, R60.1, R62.1, R64.1, R78.1, ROTATION.P$4 (4), U12.GND, U13.2 (GND), U13.3 (!EN!); also elsewhere on the board
MASTHEAD_PWR: U12.A3; also elsewhere on the board
unnamed: Q8.3 (D), ROTATION.P$1 (1)
unnamed: Q8.1 (G), R68.1
unnamed: R59.1, R60.2, U12.A0 (A0/DAC0)
unnamed: U12.RST (RESET), WDT-RST.1
unnamed: R73.1, R74.2, U17.2 (-IN)
unnamed: U13.1 (!WDO!), WDT-RST.2
unnamed: ANEMOMETER.P$1 (1), Q10.3 (D)
unnamed: Q10.1 (G), R69.1
unnamed: U12.D14 (D14/TX), U13.4 (WDI)
unnamed: R67.2, R68.2, R69.2, R70.2, U16.4 (O)
unnamed: R75.1, R76.2, U17.6 (-IN)
unnamed: R77.1, R78.2, U17.3 (+IN), U17.5 (+IN)
NEOPIXEL: U12.D9 (D9/SCK); also elsewhere on the board
PANEL1: R61.2; also elsewhere on the board
PANEL1_DIV: R61.1, R62.2, U12.A1; also elsewhere on the board
PANEL2: R63.2; also elsewhere on the board
PANEL2_DIV: R63.1, R64.2, U12.A2; also elsewhere on the board
SCL: ANEMOMETER.P$3 (3), U12.D12 (D12/SCL); also elsewhere on the board
SDA: ANEMOMETER.P$2 (2), U12.D11 (D11/SDA); also elsewhere on the board
SENSOR_PWR: U12.D8 (D8/MOSI), U16.2 (I)
SERVO_PWR: U12.D13 (D13/RX); also elsewhere on the board
SIN: R74.1, U12.A5, U17.1 (OUT)
SIN_IN: R73.2, ROTATION.P$2 (2)
TAIL_SERVO: U12.A4; also elsewhere on the board
VSELECT: Q10.2 (S), R59.2, R70.1; also elsewhere on the board

Notes on the sheet:
Microcontroller
Sensor Inputs

Board: 2 copper layers, 78 parts (2 on the bottom side), 63 nets, no tracks yet.
