ProjectLadon/PowerHardware/MastheadLight/LightBoard.brd

## EAGLE design MastheadLight/LightBoard.brd (2018-01-23)

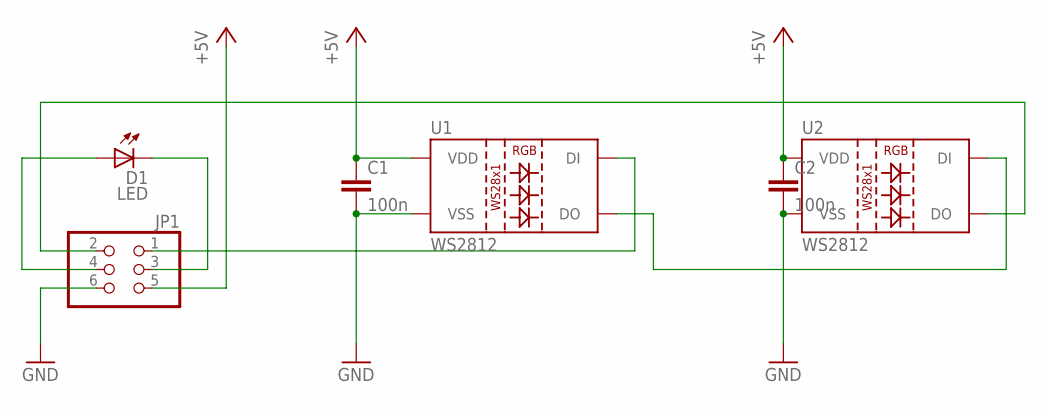
[picture p7: schematic LightBoard.sch]

Parts:
C1, C2: 100n; C0603
D1: LED; LM561C
JP1: PINHD-2X3_2.54-SMD-90°; 2X03SMD/90
U1, U2: WS2812; LED-TRICOLOR-5050-IC

Connections:
+5V: C1.1, C2.1, JP1.5, U1.3 (VDD), U1.5 (VDD), U2.3 (VDD), U2.5 (VDD)
GND: C1.2, C2.2, JP1.6, U1.6 (VSS), U2.6 (VSS)
unnamed: U1.1 (DO), U2.2 (DI)
unnamed: JP1.1, U1.2 (DI)
unnamed: JP1.2, U2.1 (DO)
unnamed: D1.A1 (A), D1.A2 (A), D1.A3 (A), JP1.4
unnamed: D1.C1 (C), D1.C2 (C), D1.C3 (C), JP1.3

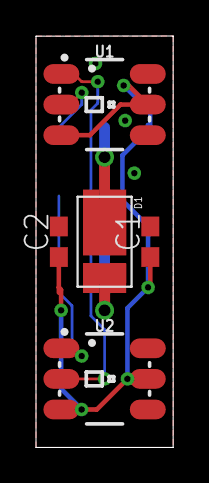
[picture p8: board LightBoard.brd from above]

Board: 2 copper layers, 7.6 x 22.9 mm, 6 parts (1 on the bottom side), 7 nets.
