ProjectLadon/PowerHardware/Combiner/BatteryChargerCombiner.brd

## EAGLE design Combiner/BatteryChargerCombiner.brd (2018-01-23)

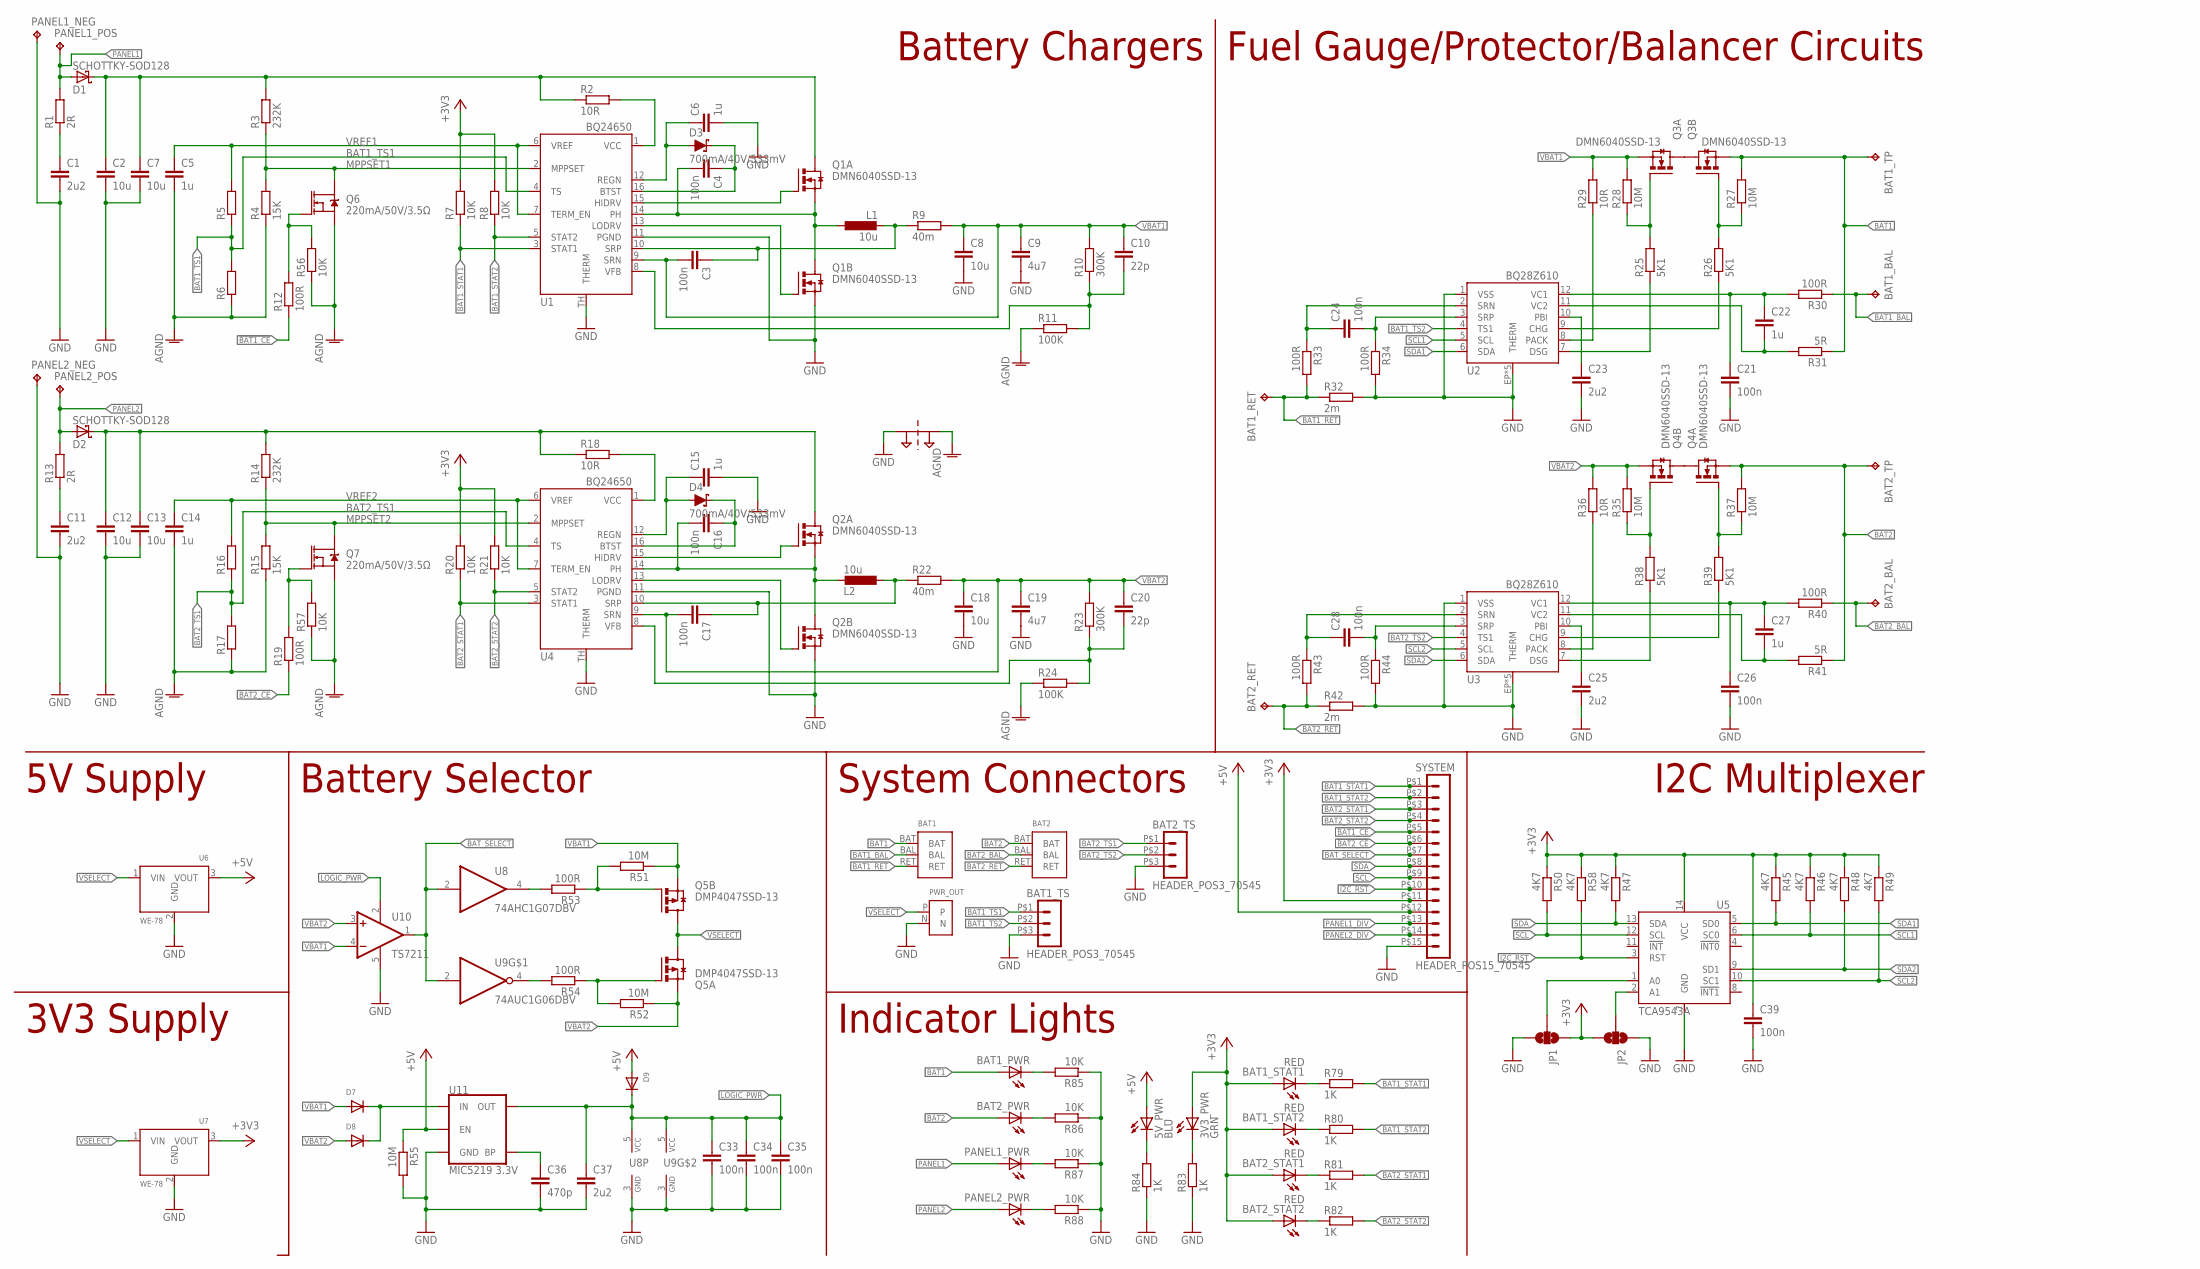
[picture p9: schematic BatteryChargerCombiner.sch, sheet 1]

Parts:
3V3_PWR: GRN; CHIP-LED0603
5V_PWR: BLU; CHIP-LED0603
BAT1, BAT2: 2S-BATTERYSMD; JST-XH3-SMD
BAT1_BAL, BAT1_RET, BAT1_TP, BAT2_BAL, BAT2_RET, BAT2_TP: TPPAD1-13Y; P1-13Y
BAT1_PWR, BAT2_PWR: LEDCHIP-LED0603; CHIP-LED0603
BAT1_STAT1, BAT1_STAT2, BAT2_STAT1, BAT2_STAT2: RED; CHIP-LED0603
BAT1_TS, BAT2_TS: HEADER_POS3_70545; 70545-POS3
C1, C11, C23, C25, C37: 2u2; C0603
C2, C7, C8, C12, C13, C18: 10u; C1210
C3, C4, C16, C17, C21, C24, C26, C28, C33, C34, C35, C39: 100n; C0603
C5, C6, C14, C15, C22, C27: 1u; C0603
C9, C19: 4u7; C1210
C10, C20: 22p; C0603
C36: 470p; C0603
D1, D2: SCHOTTKY-SOD128; SOD-128
D3, D4: 700mA/40V/533mV; SOT23-3
D7, D8, D9: DIODESOD-123; SOD-123
JP1, JP2: JUMPER-SMT_3_NO_SILK; SMT-JUMPER_3_NO_SILK
L1, L2: 10u; DG6050
PANEL1_NEG, PANEL1_POS, PANEL2_NEG, PANEL2_POS: TPPAD1-13Y; P1-13Y
PANEL1_PWR, PANEL2_PWR: LEDCHIP-LED0603; CHIP-LED0603
PWR_OUT: PWR; JST-XH2-THRUHOLE
Q1, Q2, Q3, Q4: DMN6040SSD-13; SO-08
Q5: DMP4047SSD-13; SO08
Q6, Q7: 220mA/50V/3.5Ω; SOT23-3
R1, R13: 2R; R0603
R2, R18: 10R; R1206
R3, R14: 232K; R0603
R4, R15: 15K; R0603
R5, R6, R16, R17: R-EU_R0603; R0603
R7, R8, R20, R21, R56, R57, R85, R86, R87, R88: 10K; R0603
R9, R22: 40m; R2512
R10, R23: 300K; R0603
R11, R24: 100K; R0603
R12, R19, R30, R33, R34, R40, R43, R44, R53, R54: 100R; R0603
R25, R26, R38, R39: 5K1; R0603
R27, R28, R35, R37, R51, R52, R55: 10M; R0603
R29, R36: 10R; R0603
R31, R41: 5R; R0603
R32, R42: 2m; R2512
R45, R46, R47, R48, R49, R50, R58: 4K7; R0603
R79, R80, R81, R82, R83, R84: 1K; R0603
SUPPLY1: 2PT_GND_TIE
SYSTEM: HEADER_POS15_70545; 70545-POS15
U1, U4: BQ24650; QFN16
U2, U3: BQ28Z610; PDSO-N12
U5: TCA9543A; SO-14
U6, U7: WE-78
U8: 74AHC1G07DBV; SOT23-5
U9: 74AUC1G06DBV; SOT23-5
U10: TS7211; DBV-R-PDSO-G5
U11: MIC5219 3.3V; SOT23-5

Connections:
!BAT1_CE!: R12.1, SYSTEM.P$5 (5); also elsewhere on the board
!BAT2_CE!: R19.1, SYSTEM.P$6 (6); also elsewhere on the board
!I2C_RST!: R58.2, SYSTEM.P$10 (10), U5.3 (RST); also elsewhere on the board
+3V3: 3V3_PWR.A, BAT1_STAT1.A, BAT1_STAT2.A, BAT2_STAT1.A, BAT2_STAT2.A, C39.1, JP1.1, JP2.3, R7.2, R8.2, R20.2, R21.2, R45.1, R46.1, R47.1, R48.1, R49.1, R50.1, R58.1, SYSTEM.P$11 (11), U5.14 (VCC), U7.3 (VOUT); also elsewhere on the board
+5V: 5V_PWR.A, D9.A, R55.1, SYSTEM.P$12 (12), U6.3 (VOUT), U11.3 (EN); also elsewhere on the board
AGND: C5.2, C14.2, Q6.2 (S), Q7.2 (S), R4.1, R6.1, R11.1, R15.1, R17.1, R24.1, R56.1, R57.1, SUPPLY1.P$2
BAT1: BAT1.BAT, BAT1_PWR.A, BAT1_TP.TP, Q3.1 (S), R27.2, R31.1
BAT1_BAL: BAT1.BAL, BAT1_BAL.TP, R30.1
BAT1_RET: BAT1.RET, BAT1_RET.TP, R32.1, R33.2
BAT1_STAT1: R7.1, R79.2, SYSTEM.P$1 (1), U1.3 (STAT1); also elsewhere on the board
BAT1_STAT2: R8.1, R80.2, SYSTEM.P$2 (2), U1.5 (STAT2); also elsewhere on the board
BAT1_TS1: BAT1_TS.P$1 (1), R5.1, R6.2, U1.4 (TS)
BAT1_TS2: BAT1_TS.P$2 (2), U2.4 (TS1)
BAT2: BAT2.BAT, BAT2_PWR.A, BAT2_TP.TP, Q4.3 (S), R37.2, R41.1
BAT2_BAL: BAT2.BAL, BAT2_BAL.TP, R40.1
BAT2_RET: BAT2.RET, BAT2_RET.TP, R42.1, R43.2
BAT2_STAT1: R20.1, R81.2, SYSTEM.P$3 (3), U4.3 (STAT1); also elsewhere on the board
BAT2_STAT2: R21.1, R82.2, SYSTEM.P$4 (4), U4.5 (STAT2); also elsewhere on the board
BAT2_TS1: BAT2_TS.P$1 (1), R16.1, R17.2, U4.4 (TS)
BAT2_TS2: BAT2_TS.P$2 (2), U3.4 (TS1)
BAT_SELECT: SYSTEM.P$7 (7), U8.2 (I), U9.2 (I), U10.1 (OUT); also elsewhere on the board
GND: BAT1_TS.P$3 (3), BAT2_TS.P$3 (3), C1.2, C2.2, C6.2, C7.2, C8.2, C9.2, C11.2, C12.2, C13.2, C15.2, C18.2, C19.2, C21.2, C23.2, C25.2, C26.2, C33.2, C34.2, C35.2, C36.2, C37.2, C39.2, JP1.3, JP2.1, PANEL1_NEG.TP, PANEL2_NEG.TP, PWR_OUT.N, Q1.1 (S), Q2.1 (S), R32.2, R34.2, R42.2, R44.2, R55.2, R83.1, R84.1, R85.1, R86.1, R87.1, R88.1, SUPPLY1.P$1, SYSTEM.P$15 (15), U1.11 (PGND), U1.TH (THERM), U2.1 (VSS), U2.EP (THERM), U2.EP1 (THERM), U2.EP2 (THERM), U2.EP3 (THERM), U2.EP4 (THERM), U3.1 (VSS), U3.EP (THERM), U3.EP1 (THERM), U3.EP2 (THERM), U3.EP3 (THERM), U3.EP4 (THERM), U4.11 (PGND), U4.TH (THERM), U5.7 (GND), U6.2 (GND), U7.2 (GND), U8.3 (GND), U9.3 (GND), U10.5 (GND), U11.2 (GND); also elsewhere on the board
LOGIC_PWR: C33.1, C34.1, C35.1, C37.1, D9.C, U8.5 (VCC), U9.5 (VCC), U10.2 (V+), U11.5 (OUT)
MPPSET1: Q6.3 (D), R3.1, R4.2, U1.2 (MPPSET)
MPPSET2: Q7.3 (D), R14.1, R15.2, U4.2 (MPPSET)
unnamed: C1.1, R1.1
unnamed: R2.2, U1.1 (VCC)
unnamed: C2.1, C7.1, D1.C, Q1.5 (D), Q1.6 (D), R2.1, R3.2
unnamed: Q1.4 (G), U1.15 (HIDRV)
unnamed: C4.2, L1.1, Q1.3 (S), Q1.7 (D), Q1.8 (D), U1.14 (PH)
unnamed: Q1.2 (G), U1.13 (LODRV)
unnamed: Q6.1 (G), R12.2, R56.2
unnamed: C3.1, L1.2, R9.1, U1.10 (SRP)
unnamed: C4.1, D3.3 (C), U1.16 (BTST)
unnamed: C6.1, D3.1 (A), U1.12 (REGN)
unnamed: C10.2, R10.1, R11.2, U1.8 (VFB)
unnamed: Q2.4 (G), U4.15 (HIDRV)
unnamed: BAT1_STAT1.C, R79.1
unnamed: C11.1, R13.1
unnamed: C15.1, D4.1 (A), U4.12 (REGN)
unnamed: C16.1, D4.3 (C), U4.16 (BTST)
unnamed: R29.1, U2.8 (PACK)
unnamed: C12.1, C13.1, D2.C, Q2.5 (D), Q2.6 (D), R14.2, R18.1
unnamed: C16.2, L2.2, Q2.3 (S), Q2.7 (D), Q2.8 (D), U4.14 (PH)
unnamed: Q2.2 (G), U4.13 (LODRV)
unnamed: C17.1, L2.1, R22.1, U4.10 (SRP)
unnamed: R18.2, U4.1 (VCC)
unnamed: Q7.1 (G), R19.2, R57.2
unnamed: Q3.5 (D), Q3.6 (D), Q3.7 (D), Q3.8 (D)
unnamed: Q3.4 (G), R25.2, R28.1
unnamed: C20.2, R23.1, R24.2, U4.8 (VFB)
unnamed: Q3.2 (G), R26.2, R27.1
unnamed: R25.1, U2.7 (DSG)
unnamed: Q4.5 (D), Q4.6 (D), Q4.7 (D), Q4.8 (D)
unnamed: R26.1, U2.9 (CHG)
unnamed: C21.1, C22.1, R30.2, U2.12 (VC1)
unnamed: C22.2, R31.2, U2.11 (VC2)
unnamed: C23.1, U2.10 (PBI)
unnamed: C27.2, R41.2, U3.11 (VC2)
unnamed: C28.1, R43.1, U3.2 (SRN)
unnamed: C24.1, R33.1, U2.2 (SRN)
unnamed: Q4.2 (G), R35.1, R38.2
unnamed: C24.2, R34.1, U2.3 (SRP)
unnamed: Q4.4 (G), R37.1, R39.2
unnamed: C26.1, C27.1, R40.2, U3.12 (VC1)
unnamed: R36.1, U3.8 (PACK)
unnamed: R38.1, U3.7 (DSG)
unnamed: R39.1, U3.9 (CHG)
unnamed: C25.1, U3.10 (PBI)
unnamed: C28.2, R44.1, U3.3 (SRP)
unnamed: BAT1_STAT2.C, R80.1
unnamed: Q5.4 (G), R51.2, R53.1
unnamed: BAT2_STAT1.C, R81.1
unnamed: JP1.2, U5.1 (A0)
unnamed: JP2.2, U5.2 (A1)
unnamed: Q5.2 (G), R52.2, R54.1
unnamed: R54.2, U9.4 (O)
unnamed: R53.2, U8.4 (O)
unnamed: BAT2_STAT2.C, R82.1
unnamed: D7.C, D8.C, U11.1 (IN)
unnamed: C36.1, U11.4 (BP)
unnamed: 3V3_PWR.C, R83.2
unnamed: 5V_PWR.C, R84.2
unnamed: BAT1_PWR.C, R85.2
unnamed: BAT2_PWR.C, R86.2
unnamed: PANEL1_PWR.C, R87.2
unnamed: PANEL2_PWR.C, R88.2
PANEL1: D1.A, PANEL1_POS.TP, PANEL1_PWR.A, R1.2; also elsewhere on the board
PANEL1_DIV: SYSTEM.P$13 (13); also elsewhere on the board
PANEL2: D2.A, PANEL2_POS.TP, PANEL2_PWR.A, R13.2; also elsewhere on the board
PANEL2_DIV: SYSTEM.P$14 (14); also elsewhere on the board
SCL: R50.2, SYSTEM.P$9 (9), U5.12 (SCL); also elsewhere on the board
SCL1: R46.2, U2.5 (SCL), U5.6 (SC0)
SCL2: R49.2, U3.5 (SCL), U5.10 (SC1)
SDA: R47.2, SYSTEM.P$8 (8), U5.13 (SDA); also elsewhere on the board
SDA1: R45.2, U2.6 (SDA), U5.5 (SD0)
SDA2: R48.2, U3.6 (SDA), U5.9 (SD1)
VBAT1: C3.2, C8.1, C9.1, C10.1, D7.A, Q3.3 (S), Q5.3 (S), R9.2, R10.2, R28.2, R29.2, R51.1, U1.9 (SRN), U10.4 (-IN)
VBAT2: C17.2, C18.1, C19.1, C20.1, D8.A, Q4.1 (S), Q5.1 (S), R22.2, R23.2, R35.2, R36.2, R52.1, U4.9 (SRN), U10.3 (+IN)
VREF1: C5.1, R5.2, U1.6 (VREF), U1.7 (TERM_EN)
VREF2: C14.1, R16.2, U4.6 (VREF), U4.7 (TERM_EN)
VSELECT: PWR_OUT.P, Q5.5 (D), Q5.6 (D), Q5.7 (D), Q5.8 (D), U6.1 (VIN), U7.1 (VIN); also elsewhere on the board

Notes on the sheet:
Battery Chargers
Fuel Gauge/Protector/Balancer Circuits
I2C Multiplexer
5V Supply
3V3 Supply
Battery Selector
System Connectors
Indicator Lights

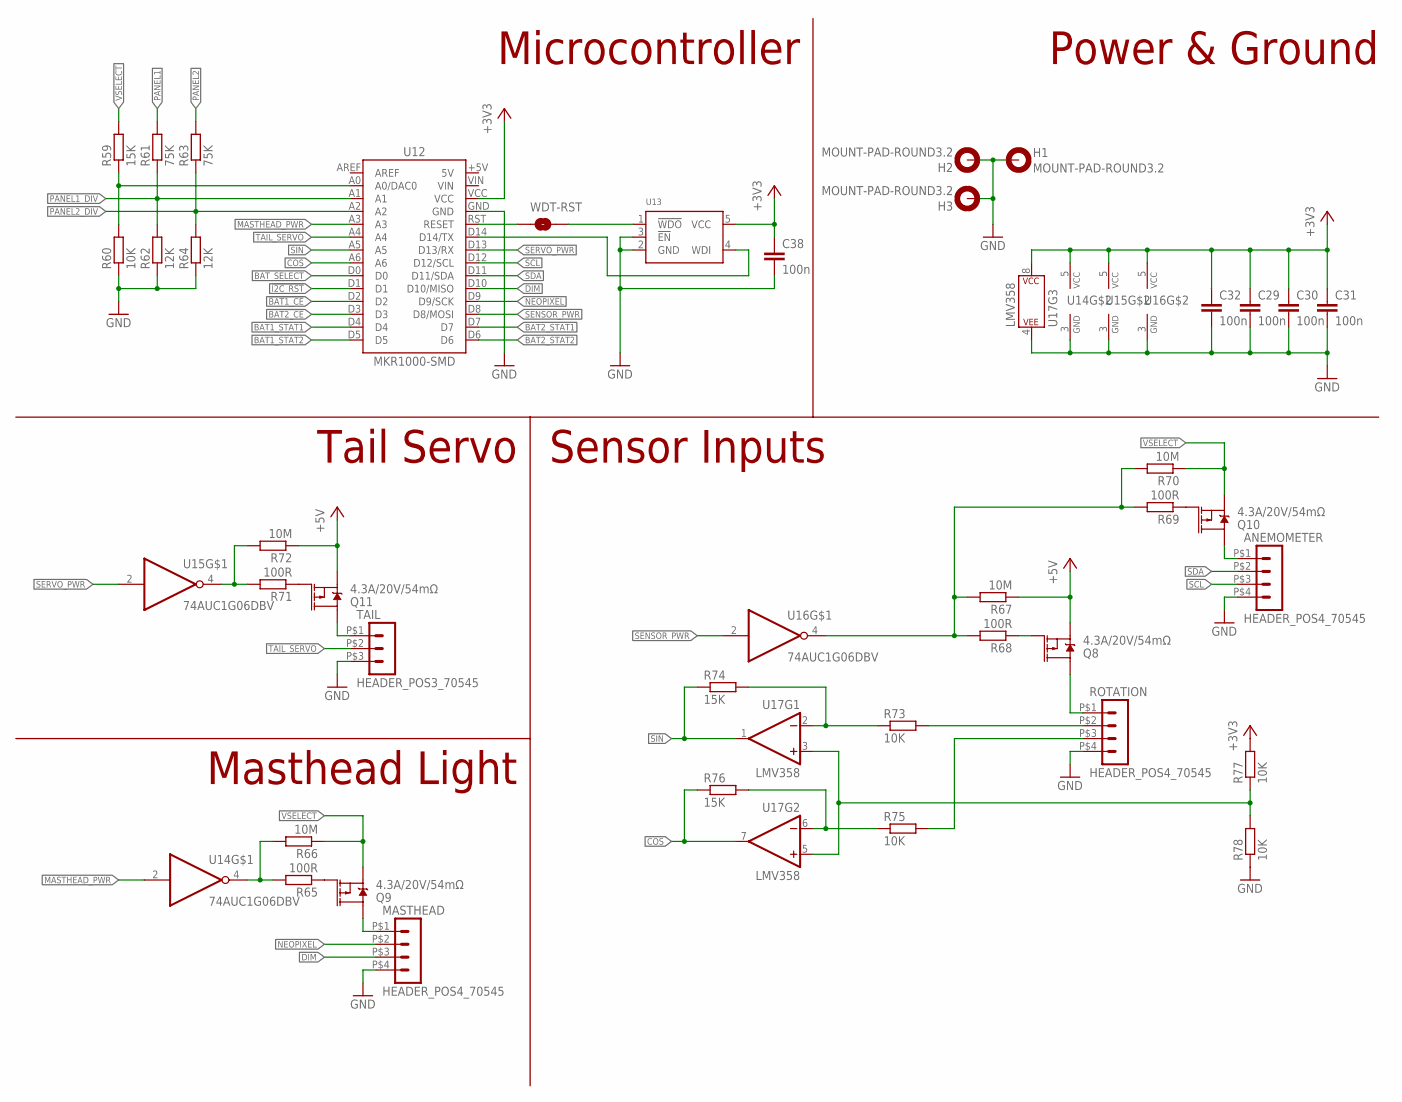
[picture p10: schematic BatteryChargerCombiner.sch, sheet 2]

Parts:
ANEMOMETER: HEADER_POS4_70545; 70545-POS4
C29, C30, C31, C32, C38: 100n; C0603
H1, H2, H3: MOUNT-PAD-ROUND3.2; 3,2-PAD
MASTHEAD: HEADER_POS4_70545; 70545-POS4
Q8, Q9, Q10, Q11: 4.3A/20V/54mΩ; SOT23-3
R59, R74, R76: 15K; R0603
R60, R73, R75, R77, R78: 10K; R0603
R61, R63: 75K; R0603
R62, R64: 12K; R0603
R65, R68, R69, R71: 100R; R0603
R66, R67, R70, R72: 10M; R0603
ROTATION: HEADER_POS4_70545; 70545-POS4
TAIL: HEADER_POS3_70545; 70545-POS3
U12: MKR1000-SMD
U13: STWD100; DBV-R-PDSO-G5
U14, U15, U16: 74AUC1G06DBV; SOT23-5
U17: LMV358; SO08
WDT-RST: JUMPER-SMT_2_NO_SILK; SMT-JUMPER_2_NO_SILK

Connections:
!BAT1_CE!: U12.D2; also elsewhere on the board
!BAT2_CE!: U12.D3; also elsewhere on the board
!I2C_RST!: U12.D1; also elsewhere on the board
+3V3: C29.1, C30.1, C31.1, C32.1, C38.1, R77.2, U12.VCC, U13.5 (VCC), U14.5 (VCC), U15.5 (VCC), U16.5 (VCC), U17.8 (P$V+); also elsewhere on the board
+5V: Q8.2 (S), Q11.2 (S), R67.1, R72.1; also elsewhere on the board
BAT1_STAT1: U12.D4; also elsewhere on the board
BAT1_STAT2: U12.D5; also elsewhere on the board
BAT2_STAT1: U12.D7; also elsewhere on the board
BAT2_STAT2: U12.D6; also elsewhere on the board
BAT_SELECT: U12.D0; also elsewhere on the board
COS: R76.1, U12.A6, U17.7 (OUT)
COS_IN: R75.2, ROTATION.P$3 (3)
DIM: MASTHEAD.P$3 (3), U12.D10 (D10/MISO)
GND: ANEMOMETER.P$4 (4), C29.2, C30.2, C31.2, C32.2, C38.2, H1.B3,2, H2.B3,2, H3.B3,2, MASTHEAD.P$4 (4), R60.1, R62.1, R64.1, R78.1, ROTATION.P$4 (4), TAIL.P$3 (3), U12.GND, U13.2 (GND), U13.3 (!EN!), U14.3 (GND), U15.3 (GND), U16.3 (GND), U17.4 (P$V-); also elsewhere on the board
MASTHEAD_PWR: U12.A3, U14.2 (I)
unnamed: Q8.3 (D), ROTATION.P$1 (1)
unnamed: Q8.1 (G), R68.1
unnamed: MASTHEAD.P$1 (1), Q9.3 (D)
unnamed: R59.1, R60.2, U12.A0 (A0/DAC0)
unnamed: U12.RST (RESET), WDT-RST.1
unnamed: R73.1, R74.2, U17.2 (-IN)
unnamed: Q9.1 (G), R65.1
unnamed: R65.2, R66.2, U14.4 (O)
unnamed: U13.1 (!WDO!), WDT-RST.2
unnamed: ANEMOMETER.P$1 (1), Q10.3 (D)
unnamed: Q10.1 (G), R69.1
unnamed: U12.D14 (D14/TX), U13.4 (WDI)
unnamed: R67.2, R68.2, R69.2, R70.2, U16.4 (O)
unnamed: Q11.3 (D), TAIL.P$1 (1)
unnamed: Q11.1 (G), R71.1
unnamed: R71.2, R72.2, U15.4 (O)
unnamed: R75.1, R76.2, U17.6 (-IN)
unnamed: R77.1, R78.2, U17.3 (+IN), U17.5 (+IN)
NEOPIXEL: MASTHEAD.P$2 (2), U12.D9 (D9/SCK)
PANEL1: R61.2; also elsewhere on the board
PANEL1_DIV: R61.1, R62.2, U12.A1; also elsewhere on the board
PANEL2: R63.2; also elsewhere on the board
PANEL2_DIV: R63.1, R64.2, U12.A2; also elsewhere on the board
SCL: ANEMOMETER.P$3 (3), U12.D12 (D12/SCL); also elsewhere on the board
SDA: ANEMOMETER.P$2 (2), U12.D11 (D11/SDA); also elsewhere on the board
SENSOR_PWR: U12.D8 (D8/MOSI), U16.2 (I)
SERVO_PWR: U12.D13 (D13/RX), U15.2 (I)
SIN: R74.1, U12.A5, U17.1 (OUT)
SIN_IN: R73.2, ROTATION.P$2 (2)
TAIL_SERVO: TAIL.P$2 (2), U12.A4
VSELECT: Q9.2 (S), Q10.2 (S), R59.2, R66.1, R70.1; also elsewhere on the board

Notes on the sheet:
Microcontroller
Sensor Inputs
Tail Servo
Masthead Light
Power & Ground

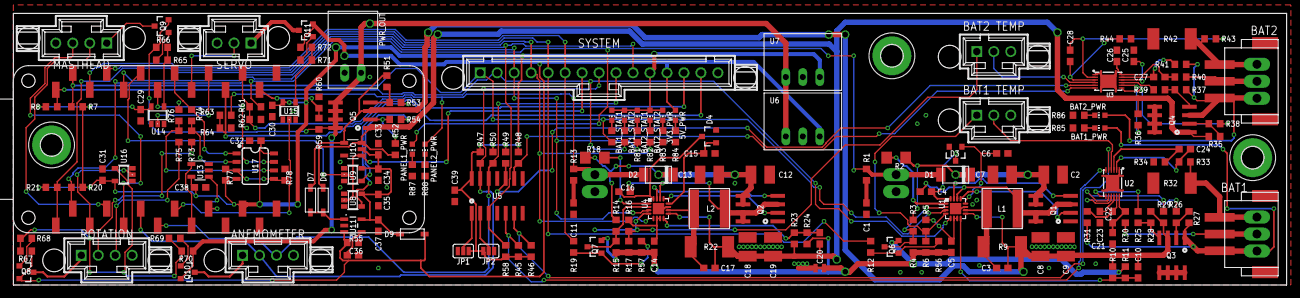
[picture p11: board BatteryChargerCombiner.brd from above]

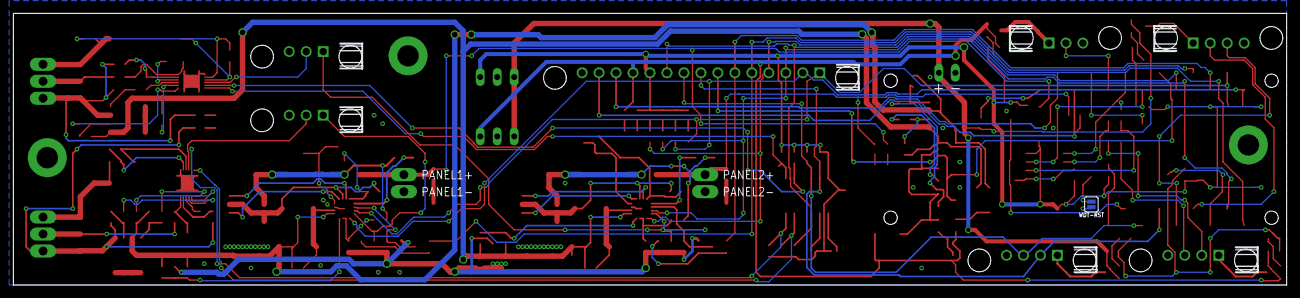
[picture p12: board BatteryChargerCombiner.brd from below]

Board: 2 copper layers, 190.5 x 40.6 mm, 201 parts (4 on the bottom side), 130 nets.
