ProjectLadon/PowerHardware/MastheadLight/BaseBoard.brd

## EAGLE design MastheadLight/BaseBoard.brd (2018-01-21)

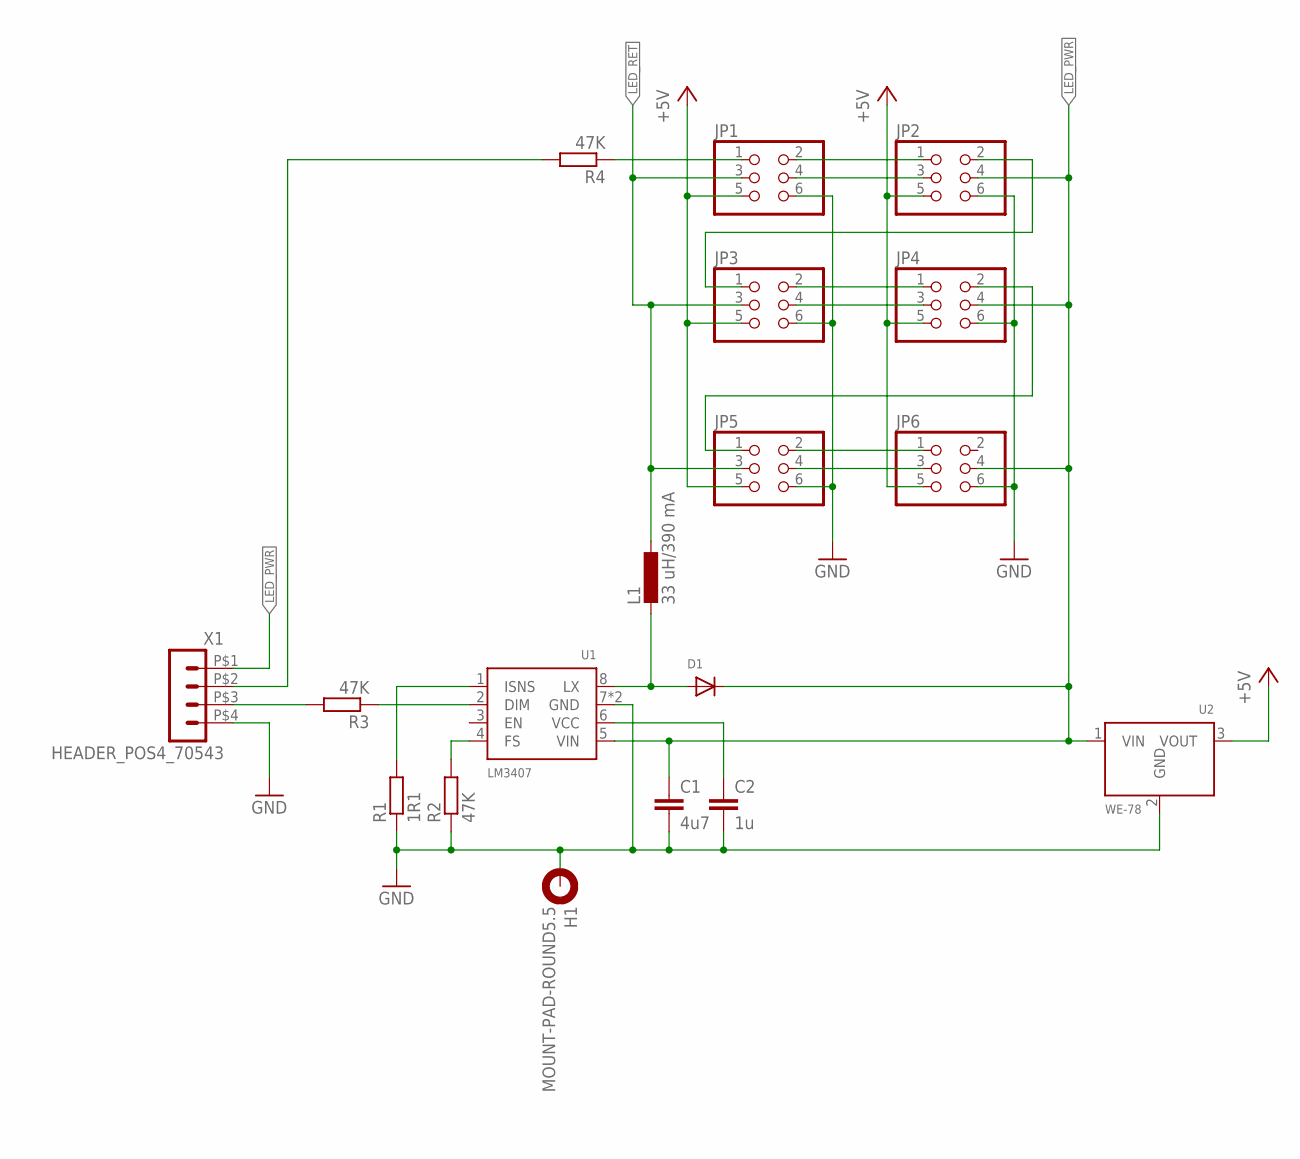
[picture p13: schematic BaseBoard.sch]

Parts:
C1: 4u7; C1206
C2: 1u; C0603
D1: DIODESOD-123; SOD-123
H1: MOUNT-PAD-ROUND5.5; 5,5-PAD
JP1, JP2, JP3, JP4, JP5, JP6: PINHD-2X3; 2X03
L1: 33 uH/390 mA; C1210
R1: 1R1; R1206
R2, R3, R4: 47K; R0603
U1: LM3407; MSOP8-GND
U2: WE-78
X1: HEADER_POS4_70543; 70543-POS4

Connections:
+5V: JP1.5, JP2.5, JP3.5, JP4.5, JP5.5, JP6.5, U2.3 (VOUT)
GND: C1.2, C2.2, H1.B5,5, JP1.6, JP2.6, JP3.6, JP4.6, JP5.6, JP6.6, R1.1, R2.1, U1.7 (GND), U1.THERM (GND), U2.2 (GND), X1.P$4 (4)
LED_PWR: C1.1, D1.C, JP2.4, JP4.4, JP6.4, U1.5 (VIN), U2.1 (VIN), X1.P$1 (1)
LED_RET: JP1.3, JP3.3, JP5.3, L1.1
unnamed: R1.2, U1.1 (ISNS)
unnamed: R2.2, U1.4 (FS)
unnamed: R3.1, U1.2 (DIM)
unnamed: D1.A, L1.2, U1.8 (LX)
unnamed: JP1.4, JP2.3
unnamed: C2.1, U1.6 (VCC)
unnamed: JP3.4, JP4.3
unnamed: JP5.4, JP6.3
unnamed: JP1.2, JP2.1
unnamed: JP2.2, JP3.1
unnamed: JP4.2, JP5.1
unnamed: JP5.2, JP6.1
unnamed: JP3.2, JP4.1
unnamed: R3.2, X1.P$3 (3)
unnamed: R4.2, X1.P$2 (2)
unnamed: JP1.1, R4.1

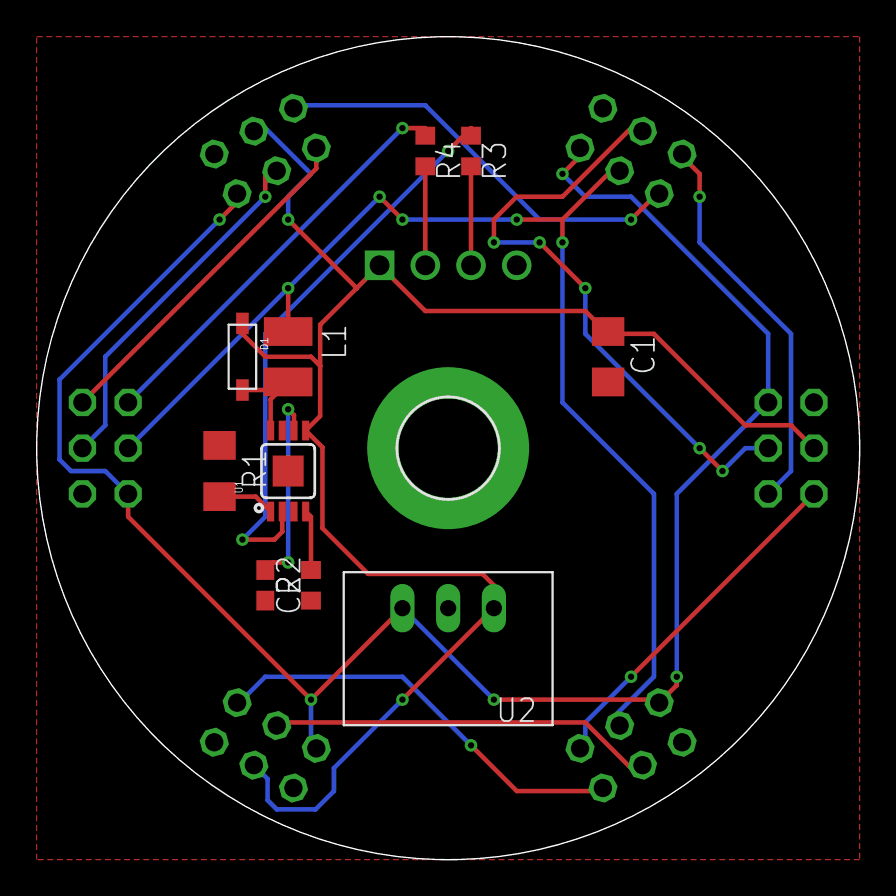
[picture p14: board BaseBoard.brd from above]

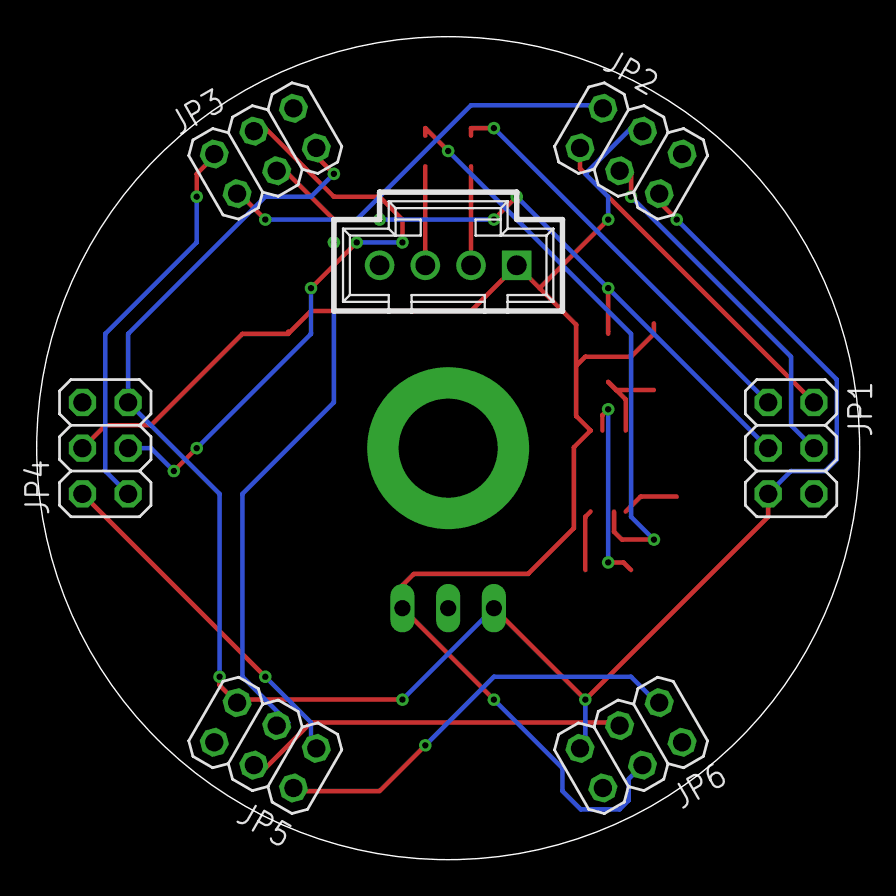
[picture p15: board BaseBoard.brd from below]

Board: 2 copper layers, 45.7 x 45.7 mm, 18 parts (7 on the bottom side), 20 nets.
