ProjectLadon/PowerHardware/(commit log)

2018-01-15 Creating charger/combiner board. Schematic complete, layout in progress
    [BatteryChargerCombiner.brd, BatteryChargerCombiner.sch]
2018-01-15 All but four airwires routed
    [BatteryChargerCombiner.brd]
2018-01-15 All signals routed. TODO: Add connectors for all temp sensors and board resistors for protection circuit sensors. Add power switching & fuses for all outputs.
    [BatteryChargerCombiner.brd]
2018-01-16 Added temp sensor inputs, power switches, and mounting holes
    [BatteryChargerCombiner.brd, BatteryChargerCombiner.sch]
2018-01-20 Silkscreen cleaned up; ready for test
    [BatteryChargerCombiner.brd, BatteryChargerCombiner.sch]
2018-01-20 Now with selectable control schemes for the masthead light -- either I2C or PWM dimming & Neopixel
    [BatteryChargerCombiner.brd, BatteryChargerCombiner.sch]
2018-01-20 Rationalized some traces
    [BatteryChargerCombiner.brd]
2018-01-21 Created masthead light boards
    [BaseBoard.brd, BaseBoard.sch, LightBoard.brd, LightBoard.sch]
2018-01-22 Shrunk board width to 1600 mil, so it will fit inside a 1.5 in PVC pipe
    [BatteryChargerCombiner.brd, BatteryChargerCombiner.sch]
2018-01-22 Now with idiot lights; still need to fix silkscreen around lights
    [BatteryChargerCombiner.brd, BatteryChargerCombiner.sch]
2018-01-23 Put together BoM for battery charger/combiner. Left out everything except the trim resistors for the temp sensor'
    [BatteryChargerCombiner.brd, BatteryChargerCombiner.sch, BatteryChargerCombinerBoM.xlsx]
2018-01-23 Put together BoM for the masthead light
    [BatteryChargerCombinerBoM.xlsx, MastheadLightBoM.xlsx]
2018-01-23 Switched the light board to the proper six-pin WS2812B footprint.
    [LightBoard.brd, LightBoard.sch]
2018-01-24 As ordered state
    [BatteryChargerCombinerBoM.xlsx]
2019-10-13 Committing the existing charger
    [BatteryCombinerControlBoard.brd, BatteryCombinerControlBoard.sch, MPPTBatteryCharger.brd, MPPTBatteryCharger.sch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]
